Theminestone/AutoTuner/project management/fotos/AutoTune.jpg

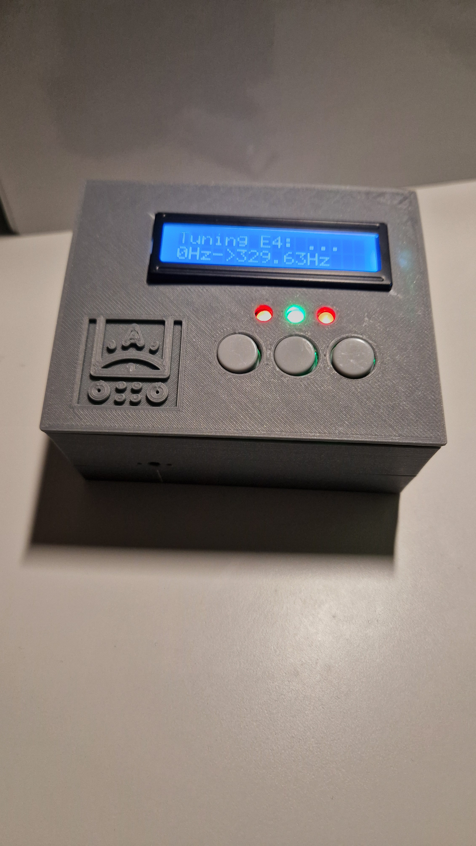
project management/fotos/AutoTune.jpg
