Theminestone/AutoTuner/project management/fotos/autotunerwide.jpg

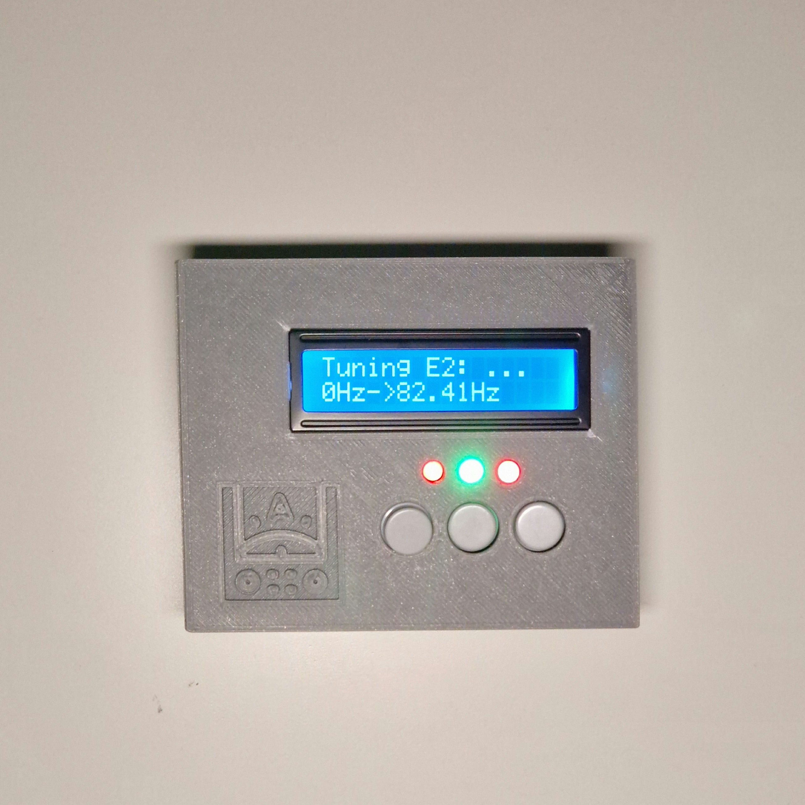
project management/fotos/autotunerwide.jpg
