Theminestone/AutoTuner/README.md

# AutoTuner
TFO Meran 2023 / 2024 - Maturaprojekt
