Theminestone/AutoTuner/pcb/v3/jlcpcb_part_placement.png

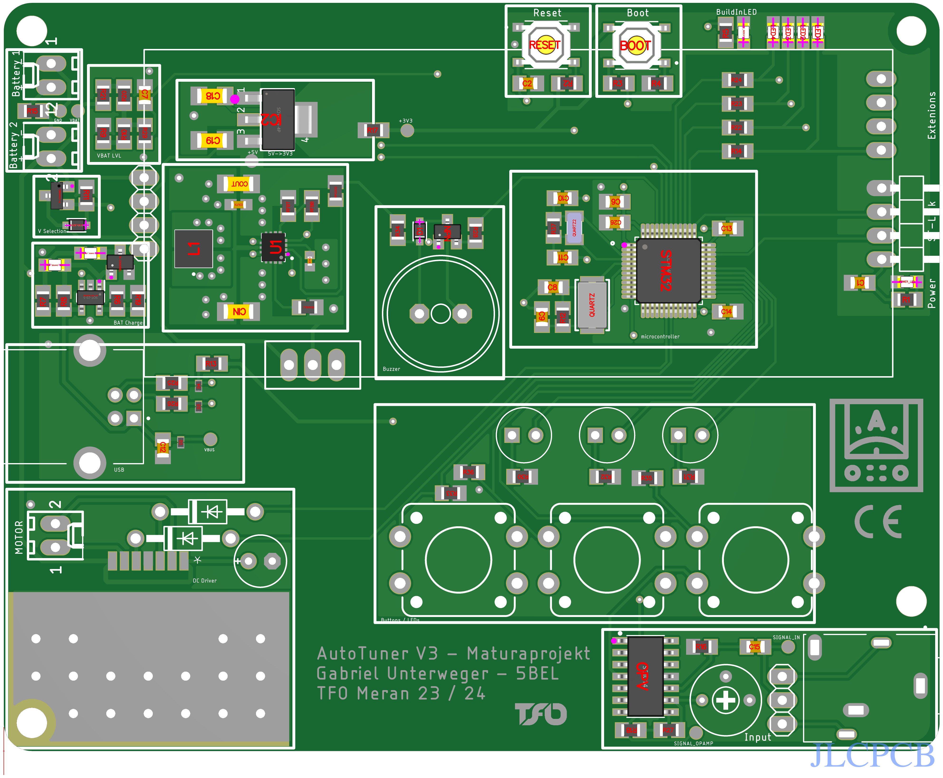
pcb/v3/jlcpcb_part_placement.png
