Theminestone/AutoTuner/pcb/v3/schematic1.png

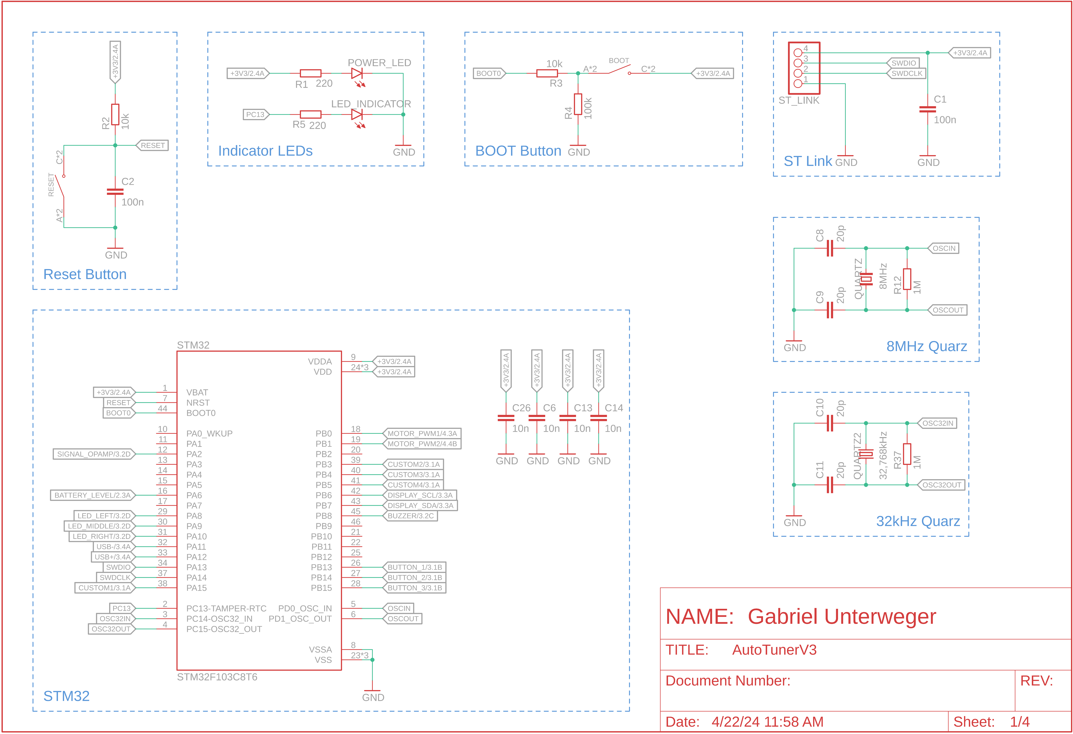
pcb/v3/schematic1.png
