Theminestone/AutoTuner/pcb/v3/schematic2.png

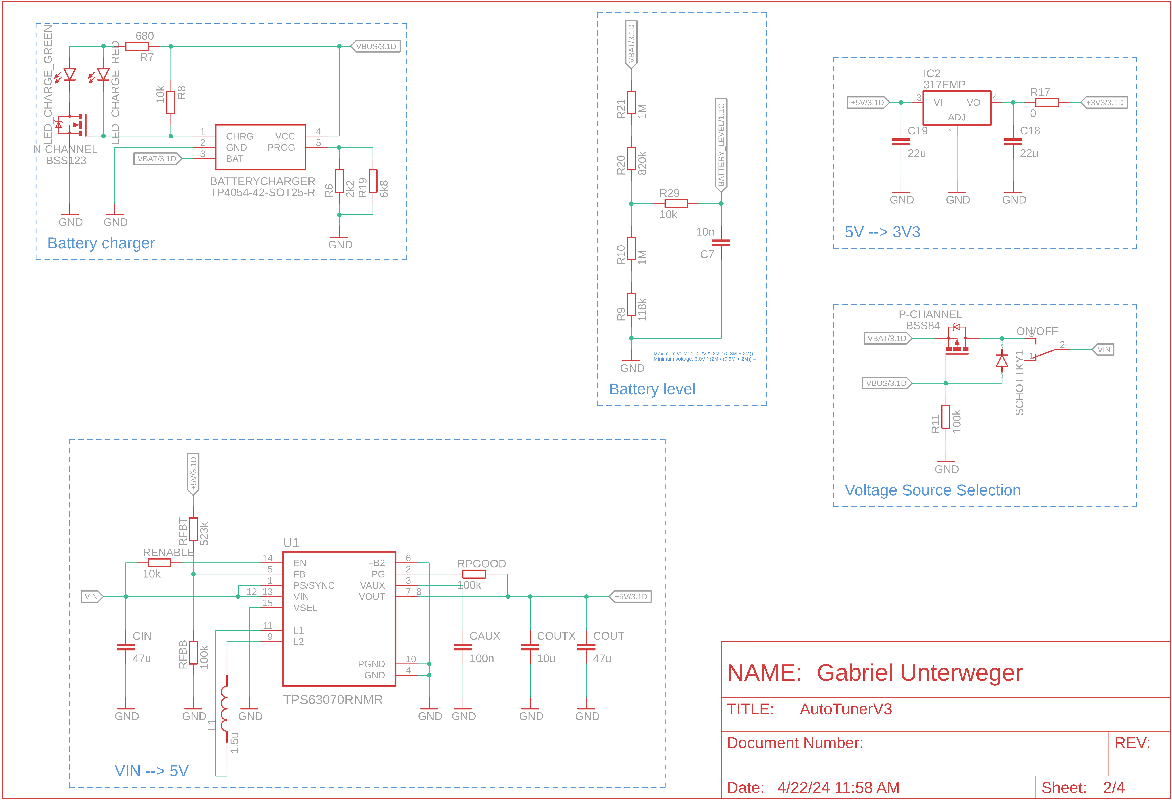
pcb/v3/schematic2.png
