Theminestone/AutoTuner/pcb/v3/schematic3.png

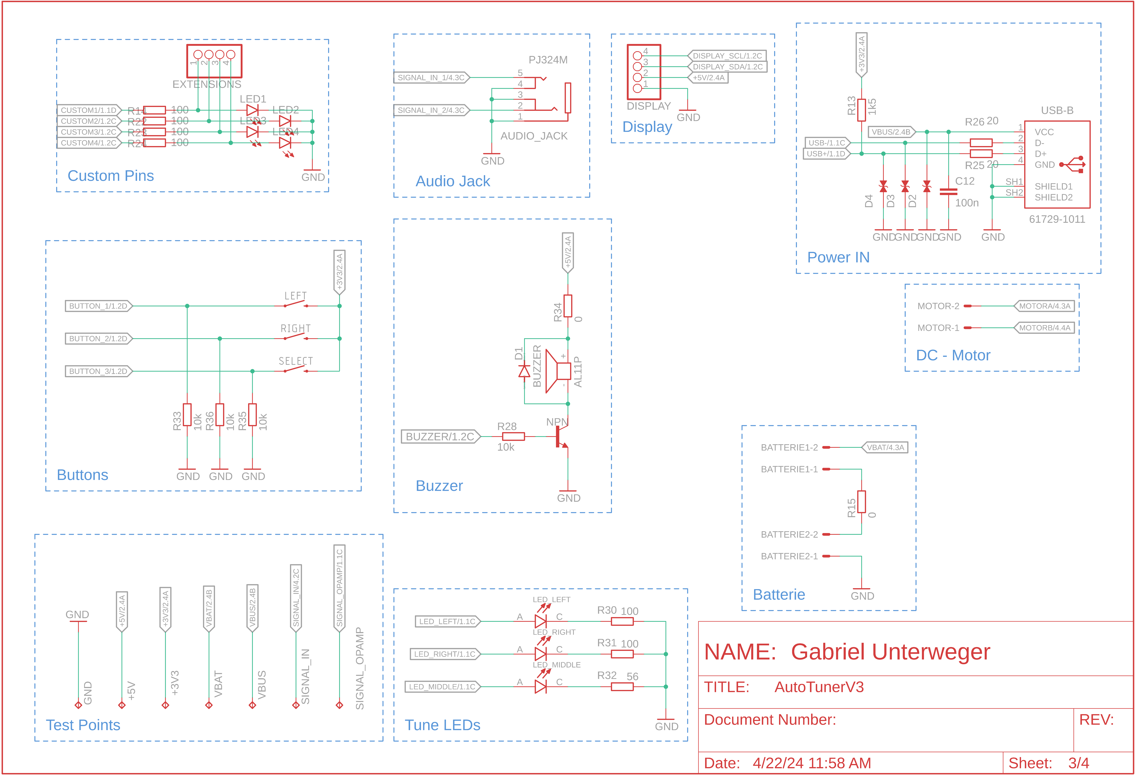
pcb/v3/schematic3.png
