Theminestone/AutoTuner/pcb/v3/schematic4.png

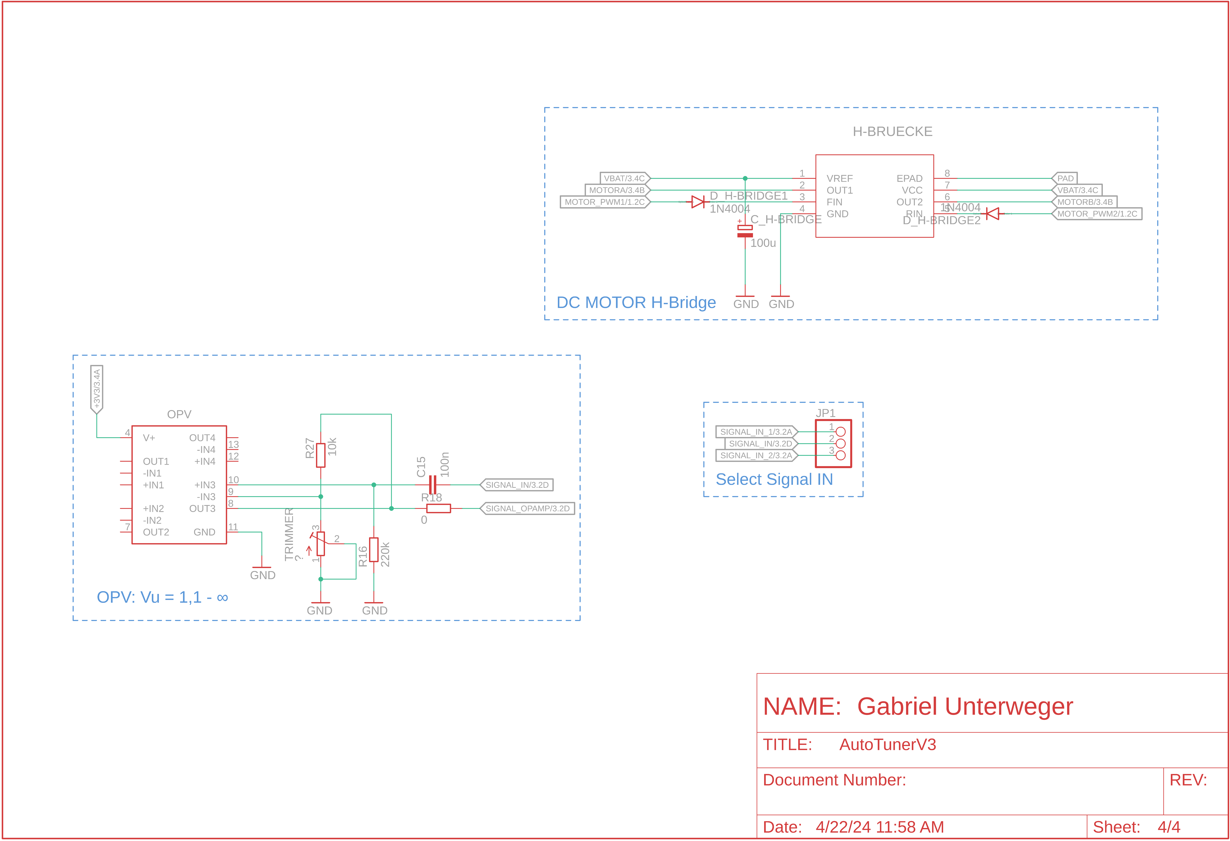
pcb/v3/schematic4.png
