Theminestone/AutoTuner/project management/fotos/20240527_224813.jpg

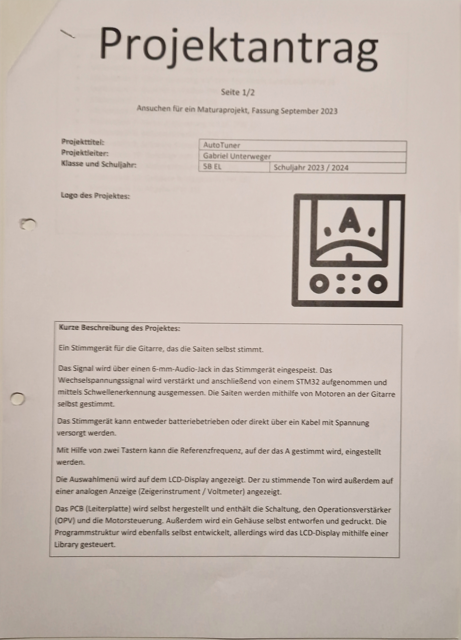
project management/fotos/20240527_224813.jpg
