Theminestone/AutoTuner/project management/fotos/20240527_224911.jpg

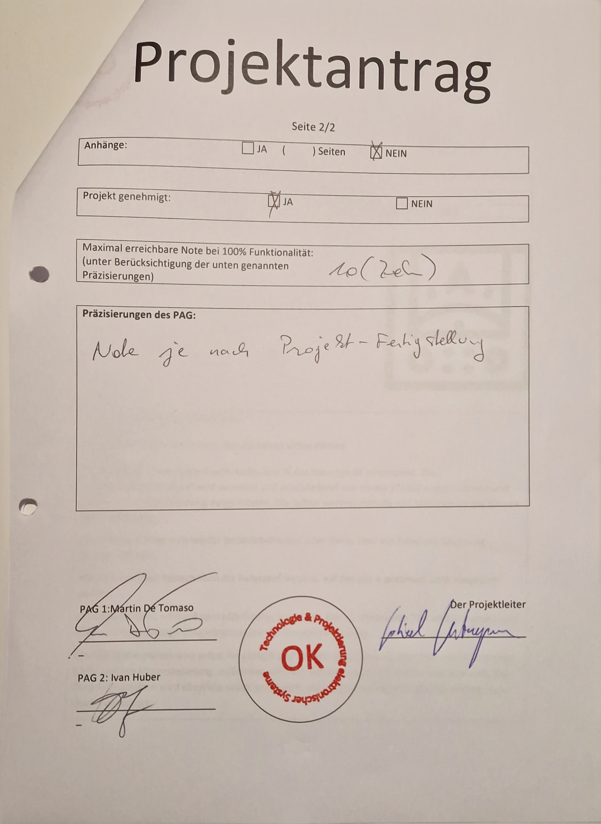
project management/fotos/20240527_224911.jpg
