Theminestone/AutoTuner/project management/fotos/20240527_225200.jpg

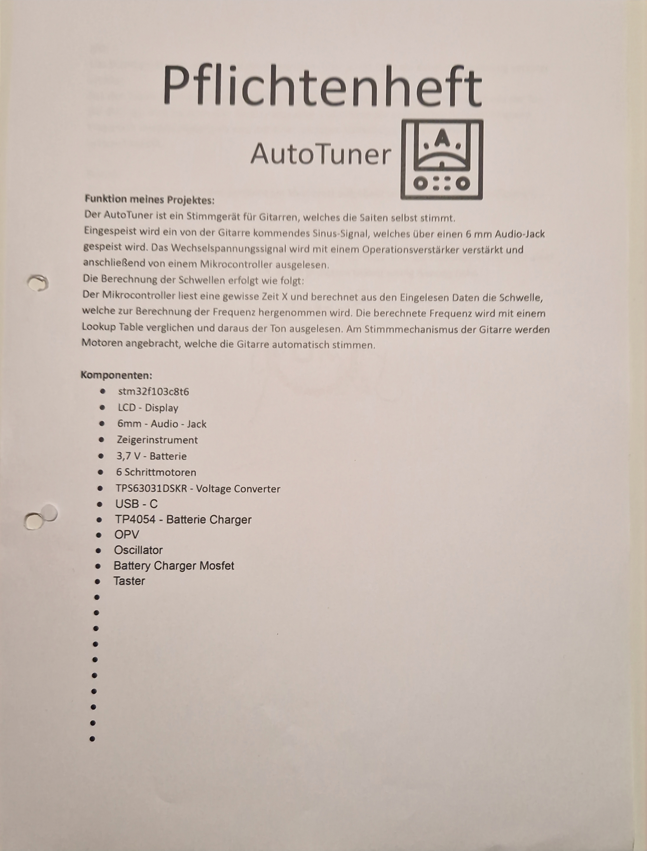
project management/fotos/20240527_225200.jpg
