Theminestone/AutoTuner/project management/fotos/20240527_225217.jpg

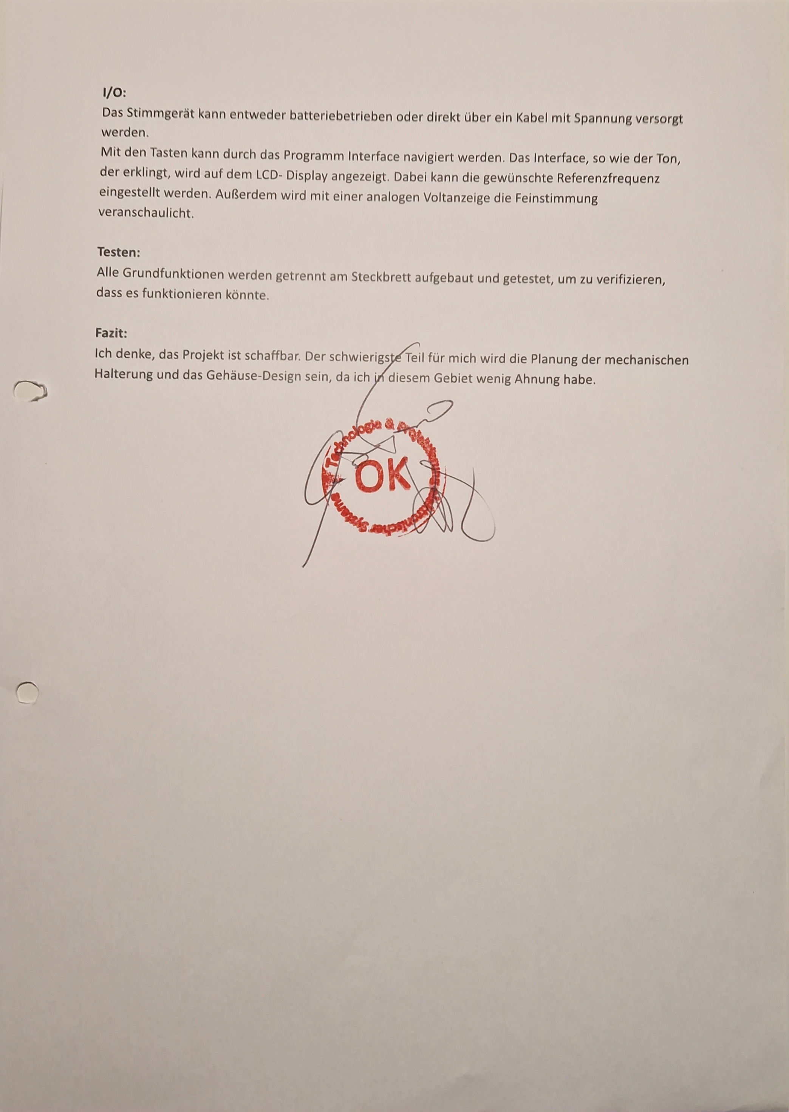
project management/fotos/20240527_225217.jpg
