Theminestone/AutoTuner/project management/fotos/autotuner.jpg

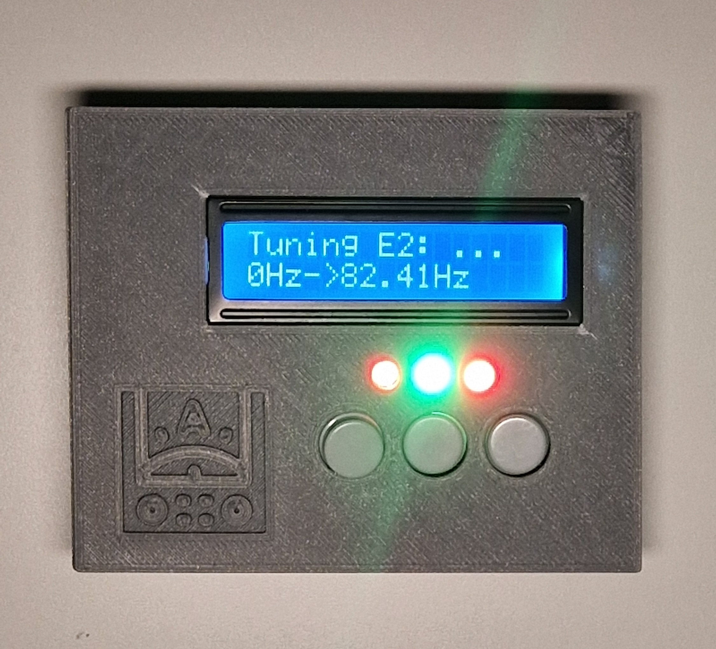
project management/fotos/autotuner.jpg
