Theminestone/AutoTuner/project management/fotos/erstes signal2.png

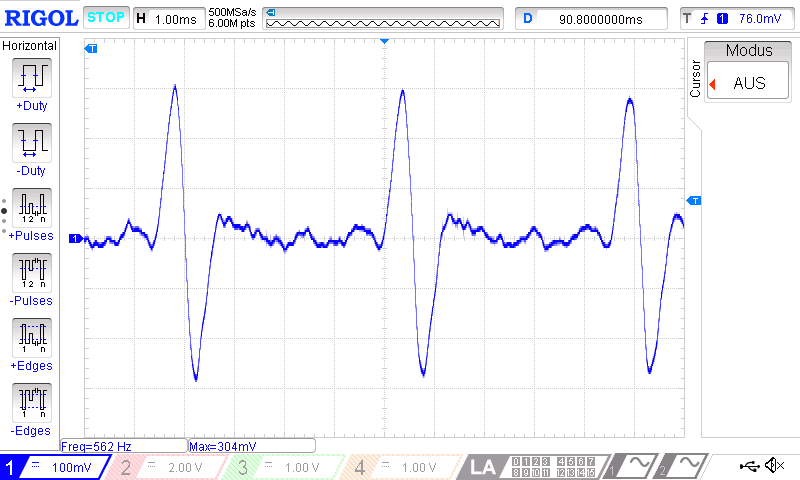
project management/fotos/erstes signal2.png
