Theminestone/AutoTuner/project management/doku/Arbeitsstunden.ods

Sheet: stunden
 | Stunden
Projektwoche | In der Schule | Offenes Labor | Zuhause | Gesammt | Kosten | 40 | €/h
1 | 5 | 0 | 2 | 7 | € 280.00
2 | 5 | 0 | 0 | 5 | € 200.00
3 | 5 | 0 | 0 | 5 | € 200.00
4 | 5 | 0 | 2 | 7 | € 280.00
5 | 5 | 0 | 0 | 5 | € 200.00
6 | 5 | 0 | 0 | 5 | € 200.00
7 | 5 | 0 | 5 | 10 | € 400.00
8 | 5 | 0 | 6 | 11 | € 440.00
9 | 5 | 0 | 12 | 17 | € 680.00
10 | 5 | 0 | 15 | 20 | € 800.00
11 | 5 | 0 | 25 | 30 | € 1,200.00
12 | 3 | 0 | 12 | 15 | € 600.00
13 | 5 | 0 | 8 | 13 | € 520.00
14 | 5 | 0 | 3 | 8 | € 320.00
15 | 0 | 0 | 2 | 2 | € 80.00
16 | 0 | 0 | 4 | 4 | € 160.00
17 | 2 | 0 | 0 | 2 | € 80.00
18 | 5 | 0 | 2 | 7 | € 280.00
19 | 5 | 0 | 0 | 5 | € 200.00
20 | 5 | 0 | 0 | 5 | € 200.00
21 | 5 | 0 | 0 | 5 | € 200.00
22 | 0 | 0 | 3 | 3 | € 120.00
23 | 2 | 0 | 2 | 4 | € 160.00
24 | 5 | 0 | 0 | 5 | € 200.00
25 | 1 | 0 | 0 | 1 | € 40.00
26 | 5 | 0 | 10 | 15 | € 600.00
27 | 5 | 0 | 12 | 17 | € 680.00
28 | 3 | 0 | 7 | 10 | € 400.00
29 | 2 | 0 | 8 | 10 | € 400.00
30 | 2 | 0 | 6 | 8 | € 320.00
31 | 5 | 0 | 5 | 10 | € 400.00
32 | 3 | 2.5 | 4 | 9.5 | € 380.00
33 | 2 | 0 | 3 | 5 | € 200.00
34 | 0 | 0 | 0 | 0 | € 0.00
35 | 0 | 0 | 2 | 2 | € 80.00
36 | 1 | 0 | 12 | 13 | € 520.00
Gesammt | 126 | 2.5 | 172 | 300.5 | € 12,020.00
IVA |  |  |  | 23.00% | € 2,764.60
Gesammt mit IVA |  |  |  |  | € 9,255.40

Sheet: berater
Datum | Stunden | Berater | Kosten
26.09.2023 | 0.25 | Huber Ivan | € 20.00 | 80 | €/h
28.09.2023 | 0.25 | Detomaso Martin | € 20.00
24.10.2023 | 0.25 | Yegorov Vladislav | € 20.00
21.11.2023 | 0.5 | Yegorov Vladislav | € 40.00
23.11.2023 | 0.5 | Yegorov Vladislav | € 40.00
23.11.2023 | 0.25 | Detomaso Martin | € 20.00
14.03.2024 | 0.25 | Tibolla Fabian | € 20.00
19.03.2024 | 3 | Tibolla Fabian | € 240.00
Gesamt | 5.25 |  | € 420.00

Sheet: materia
Art | Name | Anzahl | Einzelpreis | Gesamtpreis
Widerstände | R0805 | 152 | € 0.00 | € 0.24
Kondensatoren | C0805 | 38 | € 0.01 | € 0.23 | jlcpcb
Dioden | H5VL10B, 1N4148WS und 1N5819WS | 24 | € 0.01 | € 0.24
MOSFET P-Channel | BSS84 | 10 | € 0.02 | € 0.20
Quarz | Q13FC13500004 und X50328MSB2GI | 4 | € 0.16 | € 0.64
Spannungswandler | TPS63070RNMR | 2 | € 0.60 | € 1.20
Leds | KT-0805 | 16 | € 0.01 | € 0.21
STM32 | STM32F103C8T6 | 2 | € 1.25 | € 2.49
MOSFET N-Channel | AO3400A | 2 | € 0.07 | € 0.14
Battery Charger | TP4054-42-SOT25R | 5 | € 0.13 | € 0.64
OPAMP | LM324DT | 2 | € 0.12 | € 0.24
Spule | XFL4020-152MEC | 2 | € 1.09 | € 2.18
Taster | TS-1187A-B-A-B | 4 | € 0.02 | € 0.06
Transistor NPN | S8050-J3Y | 10 | € 0.01 | € 0.08
Spannungswandler | AMS1117-3.3 | 2 | € 0.13 | € 0.27
Extended Parts |  |  |  | € 26.00
pcb |  |  |  | -4
shipping |  |  |  | € 20.00
Steuer (22^) |  |  |  | 10.69
Gesamt |  |  |  | € 61.76
Art | Name | Anzahl | Einzelpreis | Gesamtpreis
Batterie | 6060100 3.7V 5000mAh Rechargeable LiIon Battery | 2 | € 4.86 | € 9.72
THT Leds | 5mm THT LEDs | 3 | € 0.00 | € 0.00
Pin Heads | 2,4mm Pinheads | 2 | € 0.00 | € 0.00 | extra
Schalter | 3 Pin Schalter | 1 | € 0.00 | € 0.00
Trimmer | THT Trimmer | 2 | € 0.00 | € 0.00
Display | 4 PIN LCD Display | 1 | € 0.00 | € 0.00
H-Brücke | ROHM H-BRIDGE 18V (BD6222HFP-TR) | 2 | € 4.09 | € 8.18
Motor | 6V DC Motor mit Getriebe | 2 | € 2.35 | € 4.70
Buzzer | Passiver Buzzer | 1 | € 0.00 | € 0.00
Taster | Taster mit Rundem Aufsatz | 3 | € 0.00 | € 0.00
Audio Jack | 3.5mm Audio Jack Female | 2 | € 1.00 | € 2.00
USB-B | USB-B Female | 2 | € 1.00 | € 2.00
Gesamt |  |  | € 4.86 | € 26.60

Sheet: gesamt
Gesamtkosten
 | Arbeitsstunden | € 12,020.00
 | Beraterstunden | € 420.00
 | Bestückt | € 61.76
 | Nicht Bestückt | € 26.60
 | Gesamt | € 12,528.36
