Theminestone/AutoTuner/case/Deckel.stl

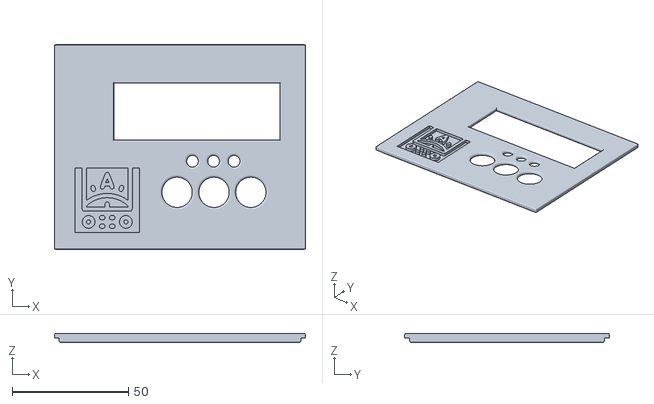
[picture p15: CAD file, 2024-05-06]
case/Deckel.stl
108.0 x 88.0 x 4.00
