Theminestone/AutoTuner/case/Motor_Aufsatz.stl

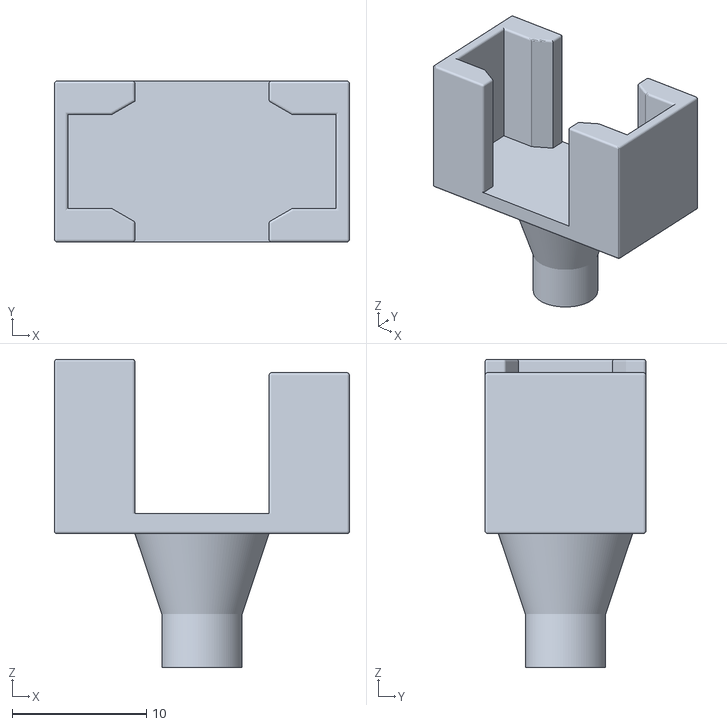
[picture p16: CAD file, 2024-04-04]
case/Motor_Aufsatz.stl
22.0 x 12.0 x 23.0
