Theminestone/AutoTuner/case/Gehaeuse.stl

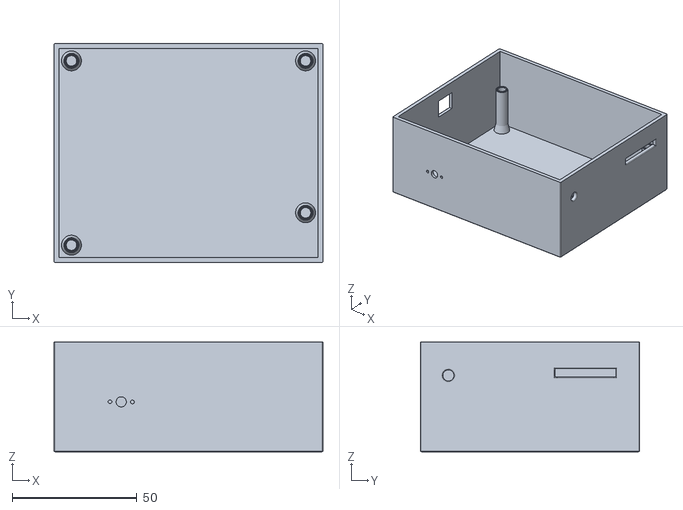
[picture p17: CAD file, 2024-04-04]
case/Gehaeuse.stl
108.0 x 88.0 x 44.0
