Theminestone/AutoTuner/pcb/v2/AutoTunerV2.brd

## EAGLE design pcb/v2/AutoTunerV2.brd (2024-06-03, an earlier design)

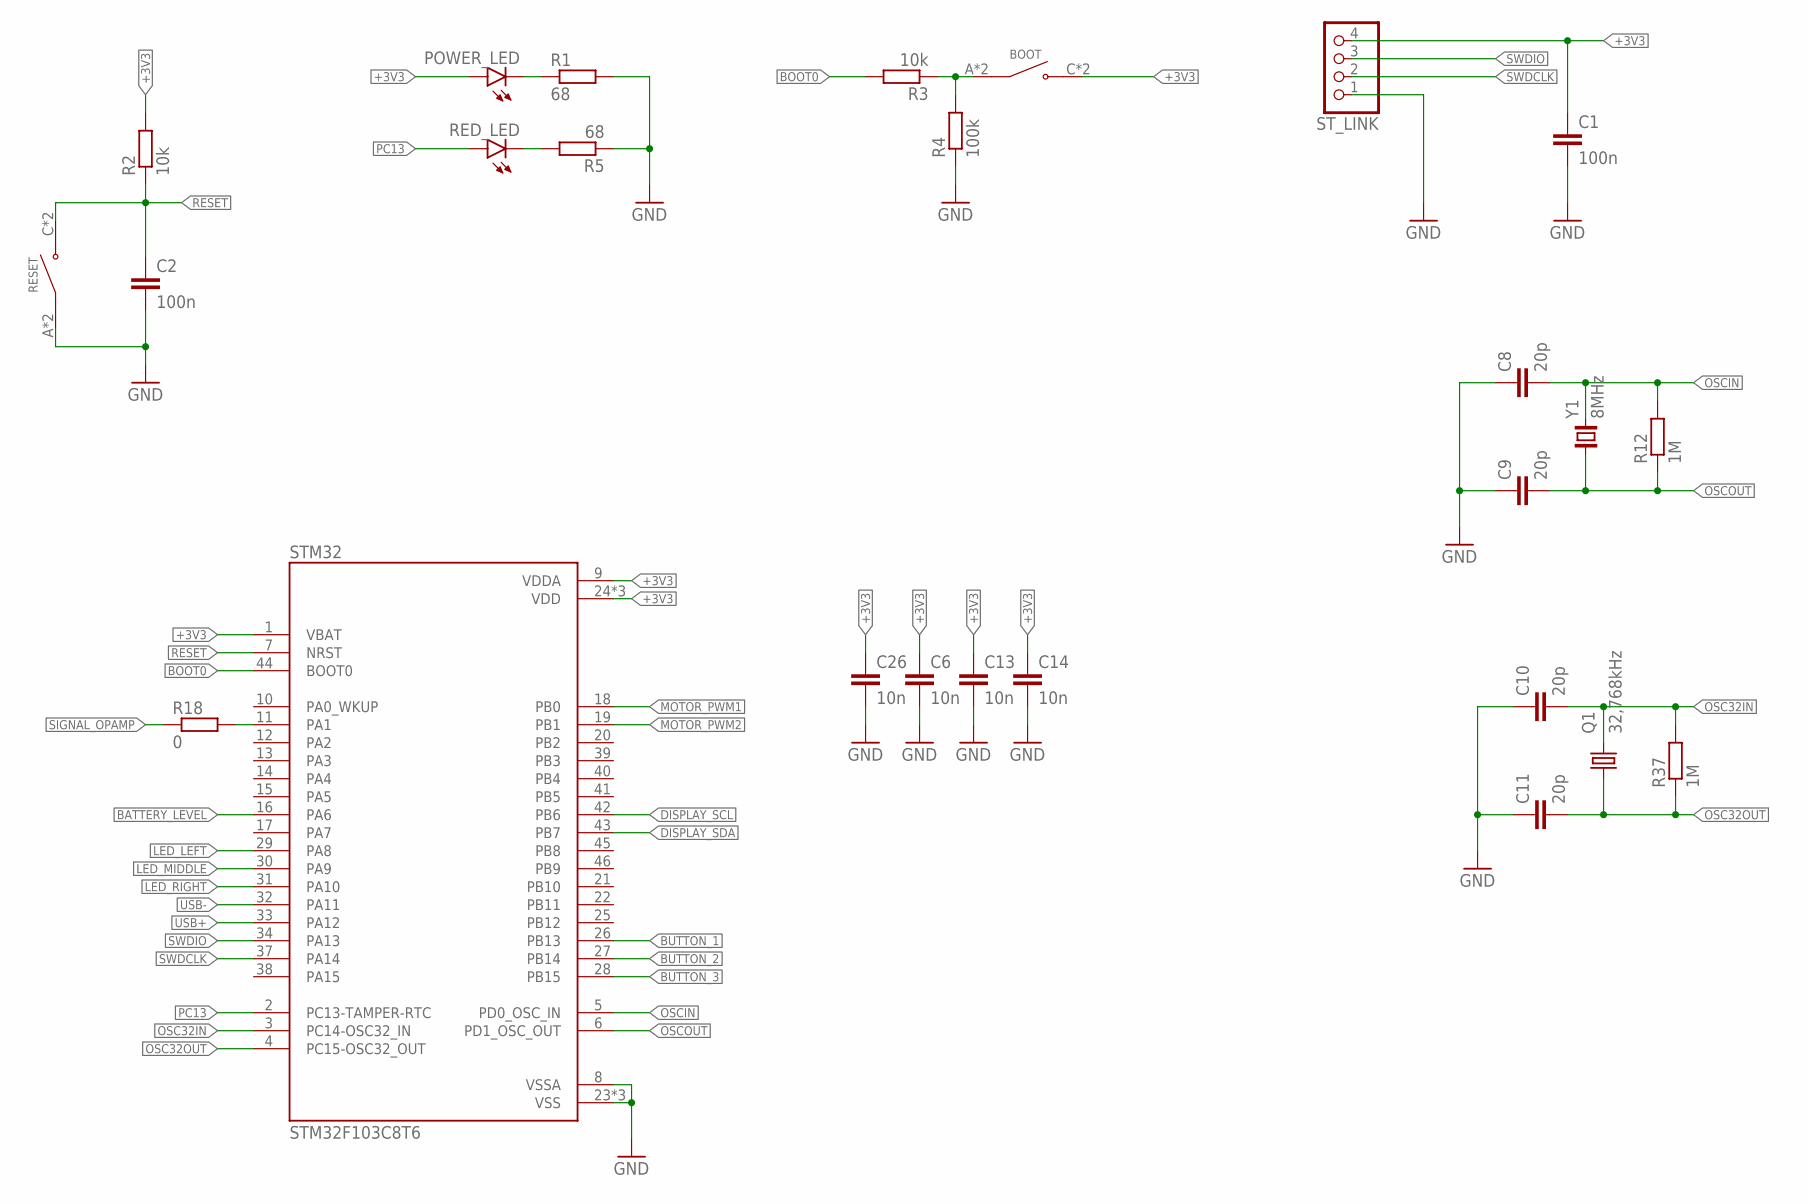
[picture p18: schematic AutoTunerV2.sch, sheet 1, mcu]

Parts:
BOOT: TS-1187A-B-A-B; SW_TS-1187A-B-A-B; LCSC_PART C318884
C1, C2: 100n; C0805
C6, C13, C14, C26: 10n; C0805
C8, C9, C10, C11: 20p; C0805
POWER_LED: LEDCHIPLED_0805; CHIPLED_0805; LCSC_PART C2297
Q1: 32,768kHz; 3.2X1.5; LCSC_PART C32346
R1, R5: 68; R0805; LCSC_PART C17802
R2, R3: 10k; R0805
R4: 100k; R0805
R12, R37: 1M; R0805
R18: 0; R0805
RED_LED: LEDCHIPLED_0805; CHIPLED_0805; LCSC_PART C84256
RESET: TS-1187A-B-A-B; SW_TS-1187A-B-A-B; LCSC_PART C318884
STM32: STM32F103C8T6; QFP50P900X900X160-48N; LCSC_PART C8734
ST_LINK: PINHD-1X4; 1X04
Y1: 8MHz; CRYSTAL_2-SMD-5X3; LCSC_PART C115962

Connections:
+3V3: BOOT.C (NO), BOOT.D (NO), C1.1, C6.1, C13.1, C14.1, C26.1, POWER_LED.A, R2.2, STM32.1 (VBAT), STM32.9 (VDDA), STM32.24 (VDD), STM32.36 (VDD), STM32.48 (VDD), ST_LINK.4; also elsewhere on the board
BATTERY_LEVEL: STM32.16 (PA6); also elsewhere on the board
BOOT0: R3.2, STM32.44 (BOOT0)
BUTTON_1: STM32.26 (PB13); also elsewhere on the board
BUTTON_2: STM32.27 (PB14); also elsewhere on the board
BUTTON_3: STM32.28 (PB15); also elsewhere on the board
DISPLAY_SCL: STM32.42 (PB6); also elsewhere on the board
DISPLAY_SDA: STM32.43 (PB7); also elsewhere on the board
GND: C1.2, C2.2, C6.2, C8.1, C9.1, C10.1, C11.1, C13.2, C14.2, C26.2, R1.2, R4.1, R5.1, RESET.A (COM), RESET.B (COM), STM32.8 (VSSA), STM32.23 (VSS), STM32.35 (VSS), STM32.47 (VSS), ST_LINK.1; also elsewhere on the board
LED_LEFT: STM32.29 (PA8); also elsewhere on the board
LED_MIDDLE: STM32.30 (PA9); also elsewhere on the board
LED_RIGHT: STM32.31 (PA10); also elsewhere on the board
MOTOR_PWM1: STM32.18 (PB0); also elsewhere on the board
MOTOR_PWM2: STM32.19 (PB1); also elsewhere on the board
unnamed: R5.2, RED_LED.C
unnamed: POWER_LED.C, R1.1
unnamed: BOOT.A (COM), BOOT.B (COM), R3.1, R4.2
unnamed: R18.2, STM32.11 (PA1)
OSC32IN: C10.2, Q1.2, R37.2, STM32.3 (PC14-OSC32_IN)
OSC32OUT: C11.2, Q1.1, R37.1, STM32.4 (PC15-OSC32_OUT)
OSCIN: C8.2, R12.2, STM32.5 (PD0_OSC_IN), Y1.2
OSCOUT: C9.2, R12.1, STM32.6 (PD1_OSC_OUT), Y1.1
PC13: RED_LED.A, STM32.2 (PC13-TAMPER-RTC)
RESET: C2.1, R2.1, RESET.C (NO), RESET.D (NO), STM32.7 (NRST)
SIGNAL_OPAMP: R18.1; also elsewhere on the board
SWDCLK: STM32.37 (PA14), ST_LINK.2
SWDIO: STM32.34 (PA13), ST_LINK.3
USB+: STM32.33 (PA12); also elsewhere on the board
USB-: STM32.32 (PA11); also elsewhere on the board

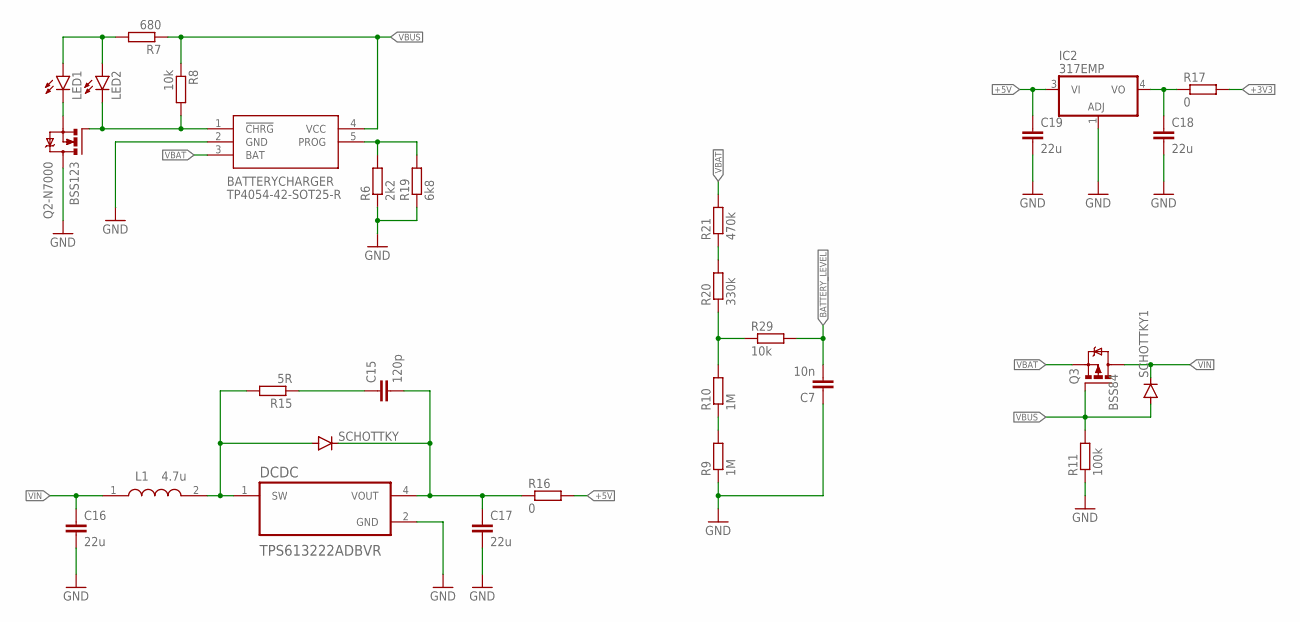
[picture p19: schematic AutoTunerV2.sch, sheet 2, battery / voltage converter]

Parts:
BATTERYCHARGER: TP4054-42-SOT25-R; SOT95P280X100-5N; LCSC_PART C32574
C7: 10n; C0805
C15: 120p; C0805
C16, C17, C18, C19: 22u; C1206; LCSC_PART C5672
DCDC: TPS613222ADBVR; SOT95P280X145-5N; LCSC_PART C2071163
IC2: 317EMP; SOT223; LCSC_PART C6186
L1: 4.7u; DFE2HCAH1R0MJ0L; LCSC_PART C3093670
LED1: LEDCHIPLED_0805; CHIPLED_0805; LCSC_PART C2297
LED2: LEDCHIPLED_0805; CHIPLED_0805; LCSC_PART C84256
Q2-N7000: BSS123; SOT23; LCSC_PART C20917
Q3: BSS84; SOT23; LCSC_PARTS C10487
R6: 2k2; R0805
R7: 680; R0805
R8, R29: 10k; R0805
R9, R10: 1M; R0805
R11: 100k; R0805
R15: 5R; R0805
R16, R17: 0; R0805
R19: 6k8; R0805
R20: 330k; R0805
R21: 470k; R0805
SCHOTTKY, SCHOTTKY1: DIODE-SOD323-R; SOD323-R; LCSC_PART C191023

Connections:
+3V3: R17.2; also elsewhere on the board
+5V: C19.1, IC2.3 (VI), R16.2; also elsewhere on the board
BATTERY_LEVEL: C7.2, R29.2; also elsewhere on the board
GND: BATTERYCHARGER.2 (GND), C7.1, C16.2, C17.2, C18.2, C19.2, DCDC.2 (GND), IC2.1 (ADJ), Q2-N7000.3 (D), R6.1, R9.1, R11.1, R19.1; also elsewhere on the board
unnamed: DCDC.1 (SW), L1.2, R15.2, SCHOTTKY.A
unnamed: R9.2, R10.1
unnamed: C15.2, C17.1, DCDC.4 (VOUT), R16.1, SCHOTTKY.C
unnamed: BATTERYCHARGER.5 (PROG), R6.2, R19.2
unnamed: BATTERYCHARGER.1 (!CHRG), LED2.C, Q2-N7000.1 (G), R8.2
unnamed: C15.1, R15.1
unnamed: LED1.A, LED2.A, R7.2
unnamed: LED1.C, Q2-N7000.2 (S)
unnamed: C18.1, IC2.4 (VO), R17.1
unnamed: R20.2, R21.1
unnamed: R10.2, R20.1, R29.1
VBAT: BATTERYCHARGER.3 (BAT), Q3.2 (S), R21.2; also elsewhere on the board
VBUS: BATTERYCHARGER.4 (VCC), Q3.1 (G), R7.1, R8.1, R11.2, SCHOTTKY1.A; also elsewhere on the board
VIN: C16.1, L1.1, Q3.3 (D), SCHOTTKY1.C

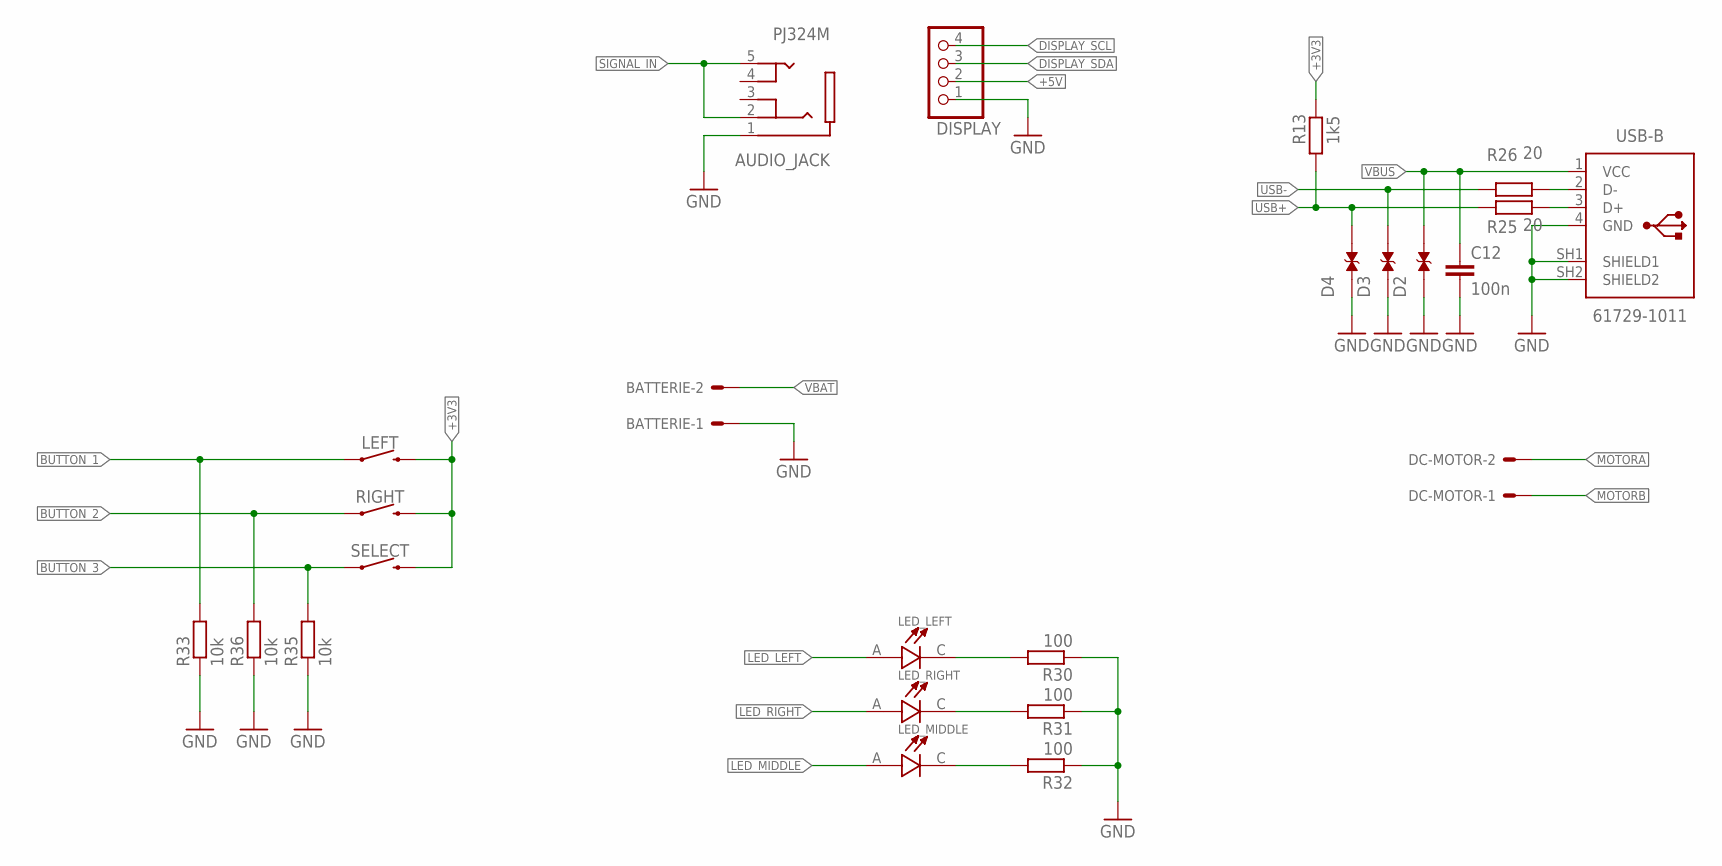
[picture p20: schematic AutoTunerV2.sch, sheet 3, I/O]

Parts:
AUDIO_JACK: PJ324M; WENZHOU_PJ324M
BATTERIE: 22-27-2021-02; 6410-02
C12: 100n; C0805
D2, D3, D4: TESD5V0L1UC_RJG; DIO_TESD5V0L1UC_RJG; LCSC_PART C7420372
DC-MOTOR: 22-27-2021-02; 6410-02
DISPLAY: PINHD-1X4; 1X04
LED_LEFT: L-53GD; LEDRD254W50D500H1060
LED_MIDDLE: L-53GD; LEDRD254W50D500H1060
LED_RIGHT: L-53GD; LEDRD254W50D500H1060
LEFT: MOMENTARY-SWITCH-SPST-PTH-12MM; TACTILE_SWITCH_PTH_12MM
R13: 1k5; R0805
R25, R26: 20; R0805
R30, R31, R32: 100; R0805
R33, R35, R36: 10k; R0805
RIGHT: MOMENTARY-SWITCH-SPST-PTH-12MM; TACTILE_SWITCH_PTH_12MM
SELECT: MOMENTARY-SWITCH-SPST-PTH-12MM; TACTILE_SWITCH_PTH_12MM
USB-B: 61729-1011; 61729-1011BLF

Connections:
+3V3: LEFT.3 (2), R13.2, RIGHT.3 (2), SELECT.3 (2); also elsewhere on the board
+5V: DISPLAY.2; also elsewhere on the board
BUTTON_1: LEFT.1, R33.2; also elsewhere on the board
BUTTON_2: R36.2, RIGHT.1; also elsewhere on the board
BUTTON_3: R35.2, SELECT.1; also elsewhere on the board
DISPLAY_SCL: DISPLAY.4; also elsewhere on the board
DISPLAY_SDA: DISPLAY.3; also elsewhere on the board
GND: AUDIO_JACK.1 (SLEEVE), BATTERIE.1, C12.2, D2.1, D3.1, D4.1, DISPLAY.1, R30.1, R31.1, R32.1, R33.1, R35.1, R36.1, USB-B.4 (GND), USB-B.SH1 (SHIELD1), USB-B.SH2 (SHIELD2); also elsewhere on the board
LED_LEFT: LED_LEFT.A; also elsewhere on the board
LED_MIDDLE: LED_MIDDLE.A; also elsewhere on the board
LED_RIGHT: LED_RIGHT.A; also elsewhere on the board
MOTORA: DC-MOTOR.2; also elsewhere on the board
MOTORB: DC-MOTOR.1; also elsewhere on the board
unnamed: LED_LEFT.C, R30.2
unnamed: LED_RIGHT.C, R31.2
unnamed: LED_MIDDLE.C, R32.2
unnamed: R25.2, USB-B.3 (D+)
unnamed: R26.2, USB-B.2 (D-)
SIGNAL_IN: AUDIO_JACK.2 (RING_1), AUDIO_JACK.5 (TIP_2); also elsewhere on the board
USB+: D4.2, R13.1, R25.1; also elsewhere on the board
USB-: D3.2, R26.1; also elsewhere on the board
VBAT: BATTERIE.2; also elsewhere on the board
VBUS: C12.1, D2.2, USB-B.1 (VCC); also elsewhere on the board

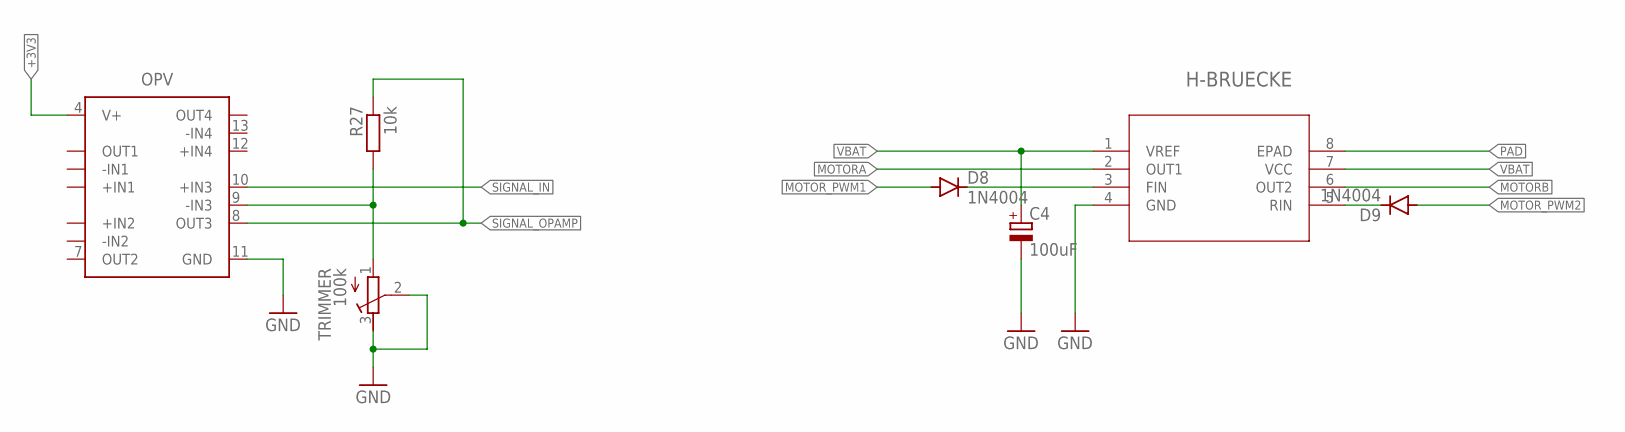
[picture p21: schematic AutoTunerV2.sch, sheet 4, Motor Steuerung / Signal Verarbeitung]

Parts:
C4: 100uF; B45181A
D8, D9: 1N4004; DO41-10
H-BRUECKE: BD6222HFP-TRHRP7_ROM-M; HRP7_ROM-M
OPV: LM324_SOIC; SOIC127P600X175-14N; LCSC_PART C71035
R27: 10k; R0805
TRIMMER: 100k; RTRIM64Y

Connections:
+3V3: OPV.4 (V+); also elsewhere on the board
GND: C4.-, H-BRUECKE.4 (GND), OPV.11 (GND), TRIMMER.2 (S), TRIMMER.3 (E); also elsewhere on the board
MOTORA: H-BRUECKE.2 (OUT1); also elsewhere on the board
MOTORB: H-BRUECKE.6 (OUT2); also elsewhere on the board
MOTOR_PWM1: D8.A; also elsewhere on the board
MOTOR_PWM2: D9.A; also elsewhere on the board
unnamed: D8.C, H-BRUECKE.3 (FIN)
unnamed: D9.C, H-BRUECKE.5 (RIN)
unnamed: OPV.9 (-IN3), R27.2, TRIMMER.1 (A)
PAD: H-BRUECKE.8 (EPAD)
SIGNAL_IN: OPV.10 (+IN3); also elsewhere on the board
SIGNAL_OPAMP: OPV.8 (OUT3), R27.1; also elsewhere on the board
VBAT: C4.+, H-BRUECKE.1 (VREF), H-BRUECKE.7 (VCC); also elsewhere on the board

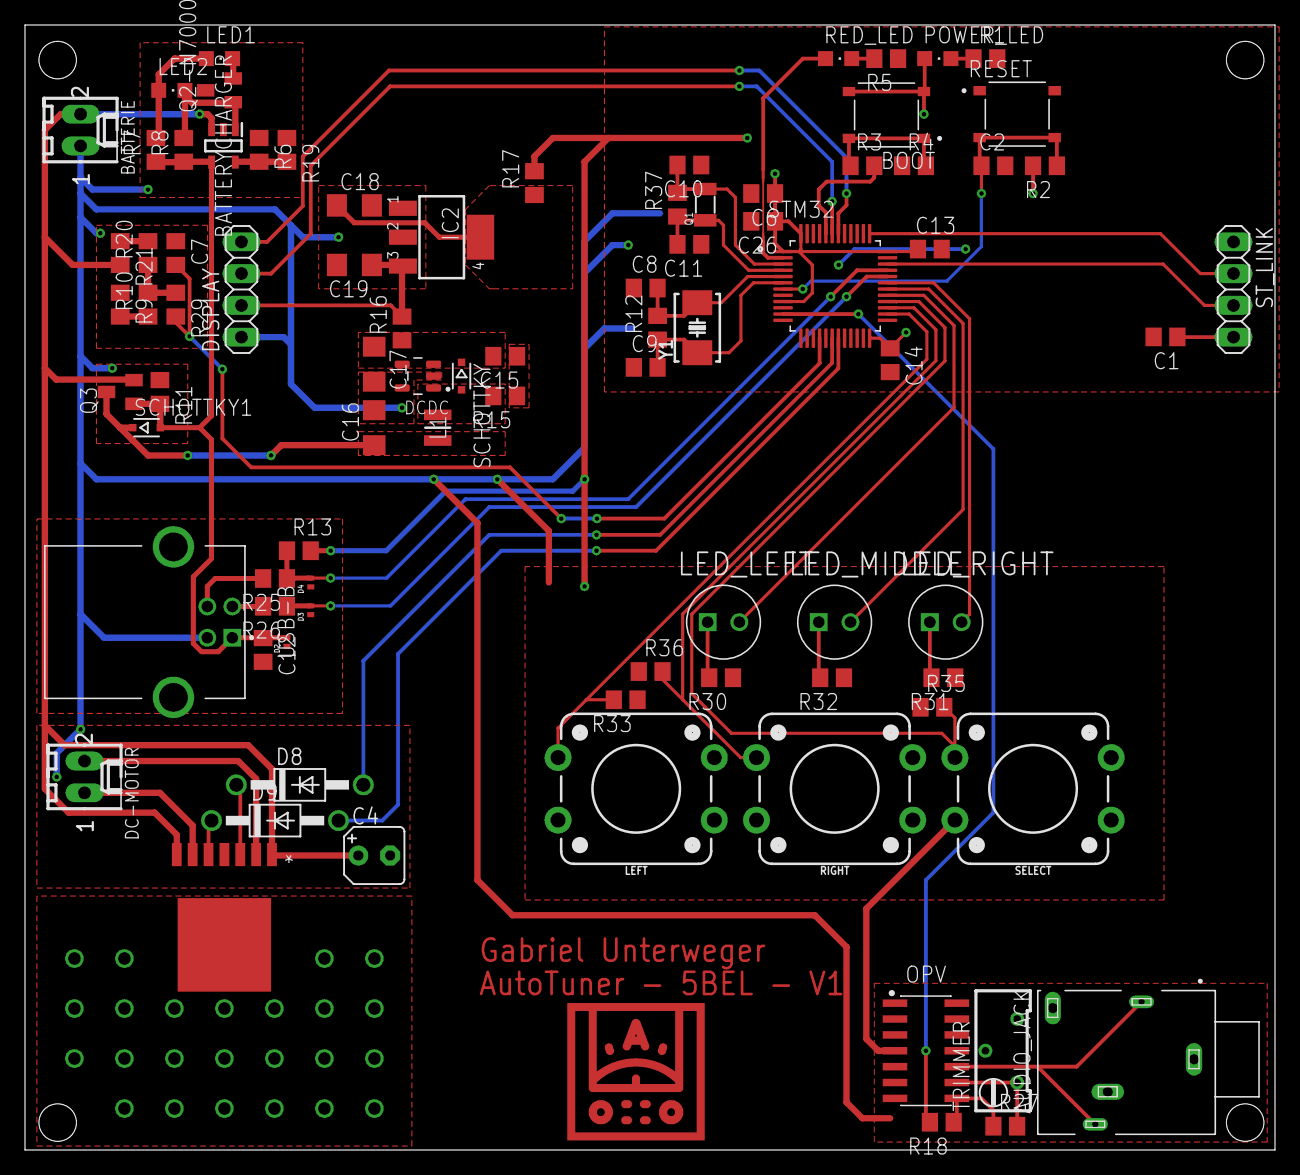
[picture p22: board AutoTunerV2.brd from above]

Board: 2 copper layers, 100.0 x 90.0 mm, 86 parts (0 on the bottom side), 55 nets.
