Theminestone/AutoTuner/pcb/v1/AutoTunerV1.brd

## EAGLE design pcb/v1/AutoTunerV1.brd (2023-12-11, an earlier design)

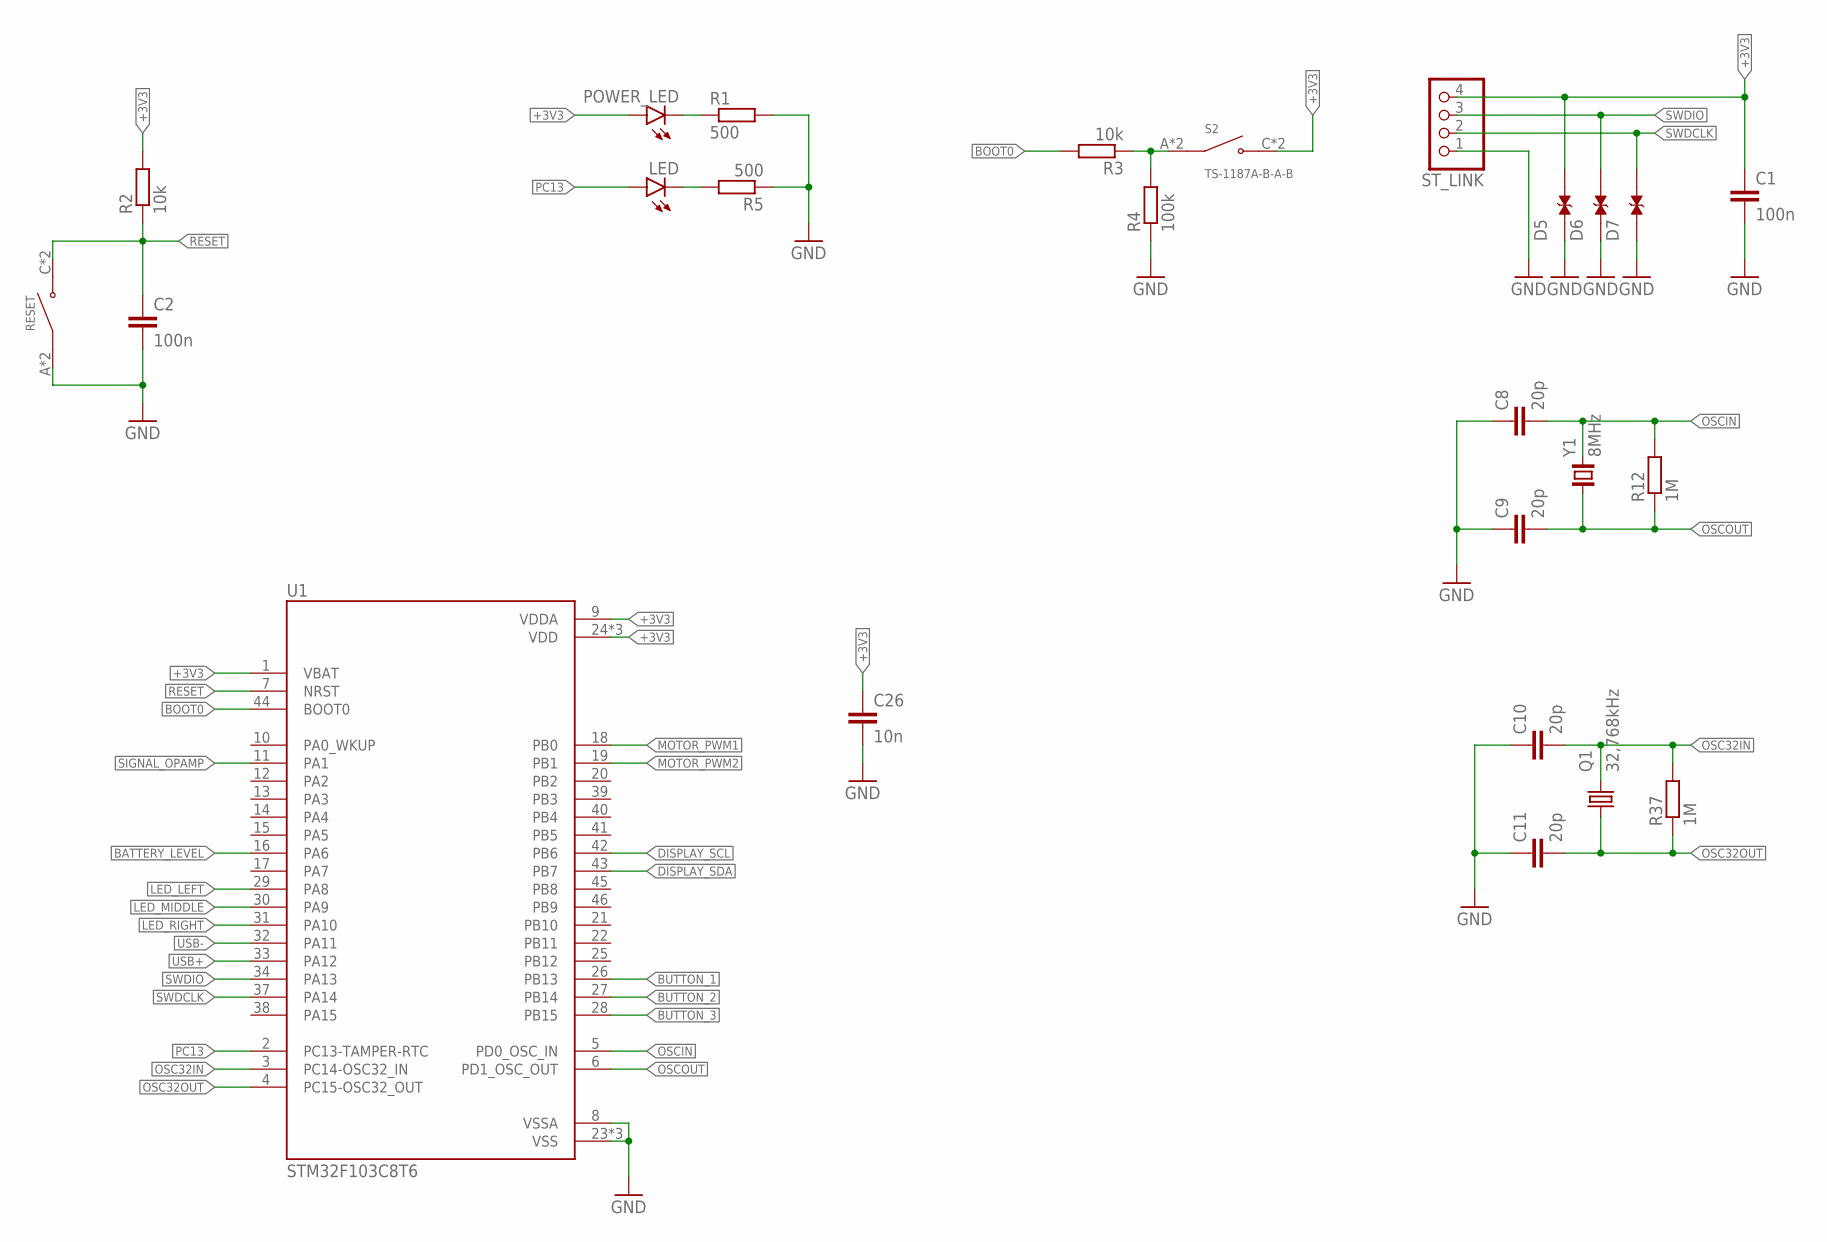
[picture p23: schematic AutoTunerV1.sch, sheet 1, mcu]

Parts:
C1, C2: 100n; C0805
C8, C9, C10, C11: 20p; C0805
C26: 10n; C0805
D5, D6, D7: TESD5V0L1UC_RJG; DIO_TESD5V0L1UC_RJG; LCSC_PART C7420372
LED: LEDCHIPLED_0805; CHIPLED_0805
POWER_LED: LEDCHIPLED_0805; CHIPLED_0805
Q1: 32,768kHz; 3.2X1.5; LCSC_PART C32346
R1, R5: 500; R0805
R2, R3: 10k; R0805
R4: 100k; R0805
R12, R37: 1M; R0805
RESET: TS-1187A-B-A-B; SW_TS-1187A-B-A-B; LCSC_PART C318884
S2: TS-1187A-B-A-B; SW_TS-1187A-B-A-B; LCSC_PART C318884
ST_LINK: PINHD-1X4; 1X04
U1: STM32F103C8T6; QFP50P900X900X160-48N; LCSC_PART C8734
Y1: 8MHz; CRYSTAL_2-SMD-5X3; LCSC_PART C115962

Connections:
+3V3: C1.1, C26.1, D5.2, POWER_LED.A, R2.2, S2.C (NO), S2.D (NO), ST_LINK.4, U1.1 (VBAT), U1.9 (VDDA), U1.24 (VDD), U1.36 (VDD), U1.48 (VDD); also elsewhere on the board
BATTERY_LEVEL: U1.16 (PA6); also elsewhere on the board
BOOT0: R3.2, U1.44 (BOOT0)
BUTTON_1: U1.26 (PB13); also elsewhere on the board
BUTTON_2: U1.27 (PB14); also elsewhere on the board
BUTTON_3: U1.28 (PB15); also elsewhere on the board
DISPLAY_SCL: U1.42 (PB6); also elsewhere on the board
DISPLAY_SDA: U1.43 (PB7); also elsewhere on the board
GND: C1.2, C2.2, C8.1, C9.1, C10.1, C11.1, C26.2, D5.1, D6.1, D7.1, R1.2, R4.1, R5.1, RESET.A (COM), RESET.B (COM), ST_LINK.1, U1.8 (VSSA), U1.23 (VSS), U1.35 (VSS), U1.47 (VSS); also elsewhere on the board
LED_LEFT: U1.29 (PA8); also elsewhere on the board
LED_MIDDLE: U1.30 (PA9); also elsewhere on the board
LED_RIGHT: U1.31 (PA10); also elsewhere on the board
MOTOR_PWM1: U1.18 (PB0); also elsewhere on the board
MOTOR_PWM2: U1.19 (PB1); also elsewhere on the board
unnamed: LED.C, R5.2
unnamed: POWER_LED.C, R1.1
unnamed: R3.1, R4.2, S2.A (COM), S2.B (COM)
OSC32IN: C10.2, Q1.2, R37.2, U1.3 (PC14-OSC32_IN)
OSC32OUT: C11.2, Q1.1, R37.1, U1.4 (PC15-OSC32_OUT)
OSCIN: C8.2, R12.2, U1.5 (PD0_OSC_IN), Y1.2
OSCOUT: C9.2, R12.1, U1.6 (PD1_OSC_OUT), Y1.1
PC13: LED.A, U1.2 (PC13-TAMPER-RTC)
RESET: C2.1, R2.1, RESET.C (NO), RESET.D (NO), U1.7 (NRST)
SIGNAL_OPAMP: U1.11 (PA1); also elsewhere on the board
SWDCLK: D7.2, ST_LINK.2, U1.37 (PA14)
SWDIO: D6.2, ST_LINK.3, U1.34 (PA13)
USB+: U1.33 (PA12); also elsewhere on the board
USB-: U1.32 (PA11); also elsewhere on the board

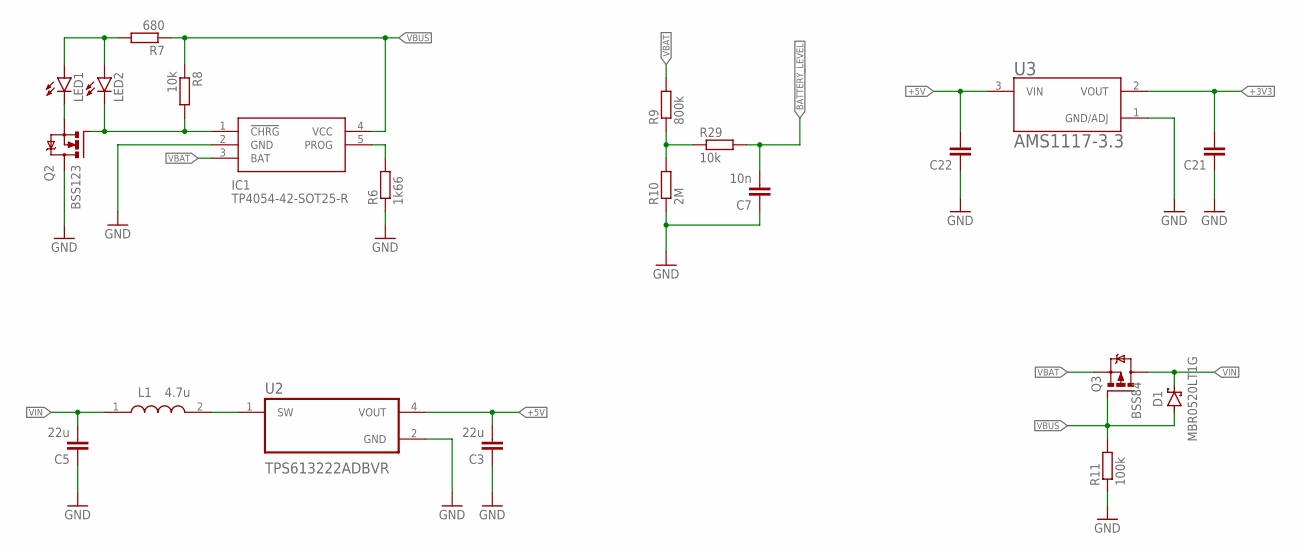
[picture p24: schematic AutoTunerV1.sch, sheet 2, battery / voltage converter]

Parts:
C3, C5: 22u; C0805
C7: 10n; C0805
C21, C22: C-EUC0805; C0805
D1: MBR0520LT1G; SODFL3718X115; LCSC_PART C191023
IC1: TP4054-42-SOT25-R; SOT95P280X100-5N; LCSC_PART C32574
L1: 4.7u; DFE2HCAH1R0MJ0L; LCSC_PART C391306
LED1, LED2: LEDCHIPLED_0805; CHIPLED_0805
Q2: BSS123; SOT23; LCSC_PART C20917
Q3: BSS84; SOT23; LCSC_PARTS C10487
R6: 1k66; R0805
R7: 680; R0805
R8, R29: 10k; R0805
R9: 800k; R0805
R10: 2M; R0805
R11: 100k; R0805
U2: TPS613222ADBVR; SOT95P280X145-5N; LCSC_PART C2071163
U3: AMS1117-3.3; SOT229P700X180-4N; LCSC_PART C6186

Connections:
+3V3: C21.2, U3.2 (VOUT); also elsewhere on the board
+5V: C3.2, C22.2, U2.4 (VOUT), U3.3 (VIN); also elsewhere on the board
BATTERY_LEVEL: C7.2, R29.2; also elsewhere on the board
GND: C3.1, C5.1, C7.1, C21.1, C22.1, IC1.2 (GND), Q2.3 (D), R6.1, R10.1, R11.1, U2.2 (GND), U3.1 (GND/ADJ); also elsewhere on the board
unnamed: L1.2, U2.1 (SW)
unnamed: R9.1, R10.2, R29.1
unnamed: IC1.5 (PROG), R6.2
unnamed: IC1.1 (!CHRG), LED2.C, Q2.1 (G), R8.2
unnamed: LED1.A, LED2.A, R7.2
unnamed: LED1.C, Q2.2 (S)
VBAT: IC1.3 (BAT), Q3.2 (S), R9.2; also elsewhere on the board
VBUS: D1.2 (A), IC1.4 (VCC), Q3.1 (G), R7.1, R8.1, R11.2; also elsewhere on the board
VIN: C5.2, D1.1 (C), L1.1, Q3.3 (D)

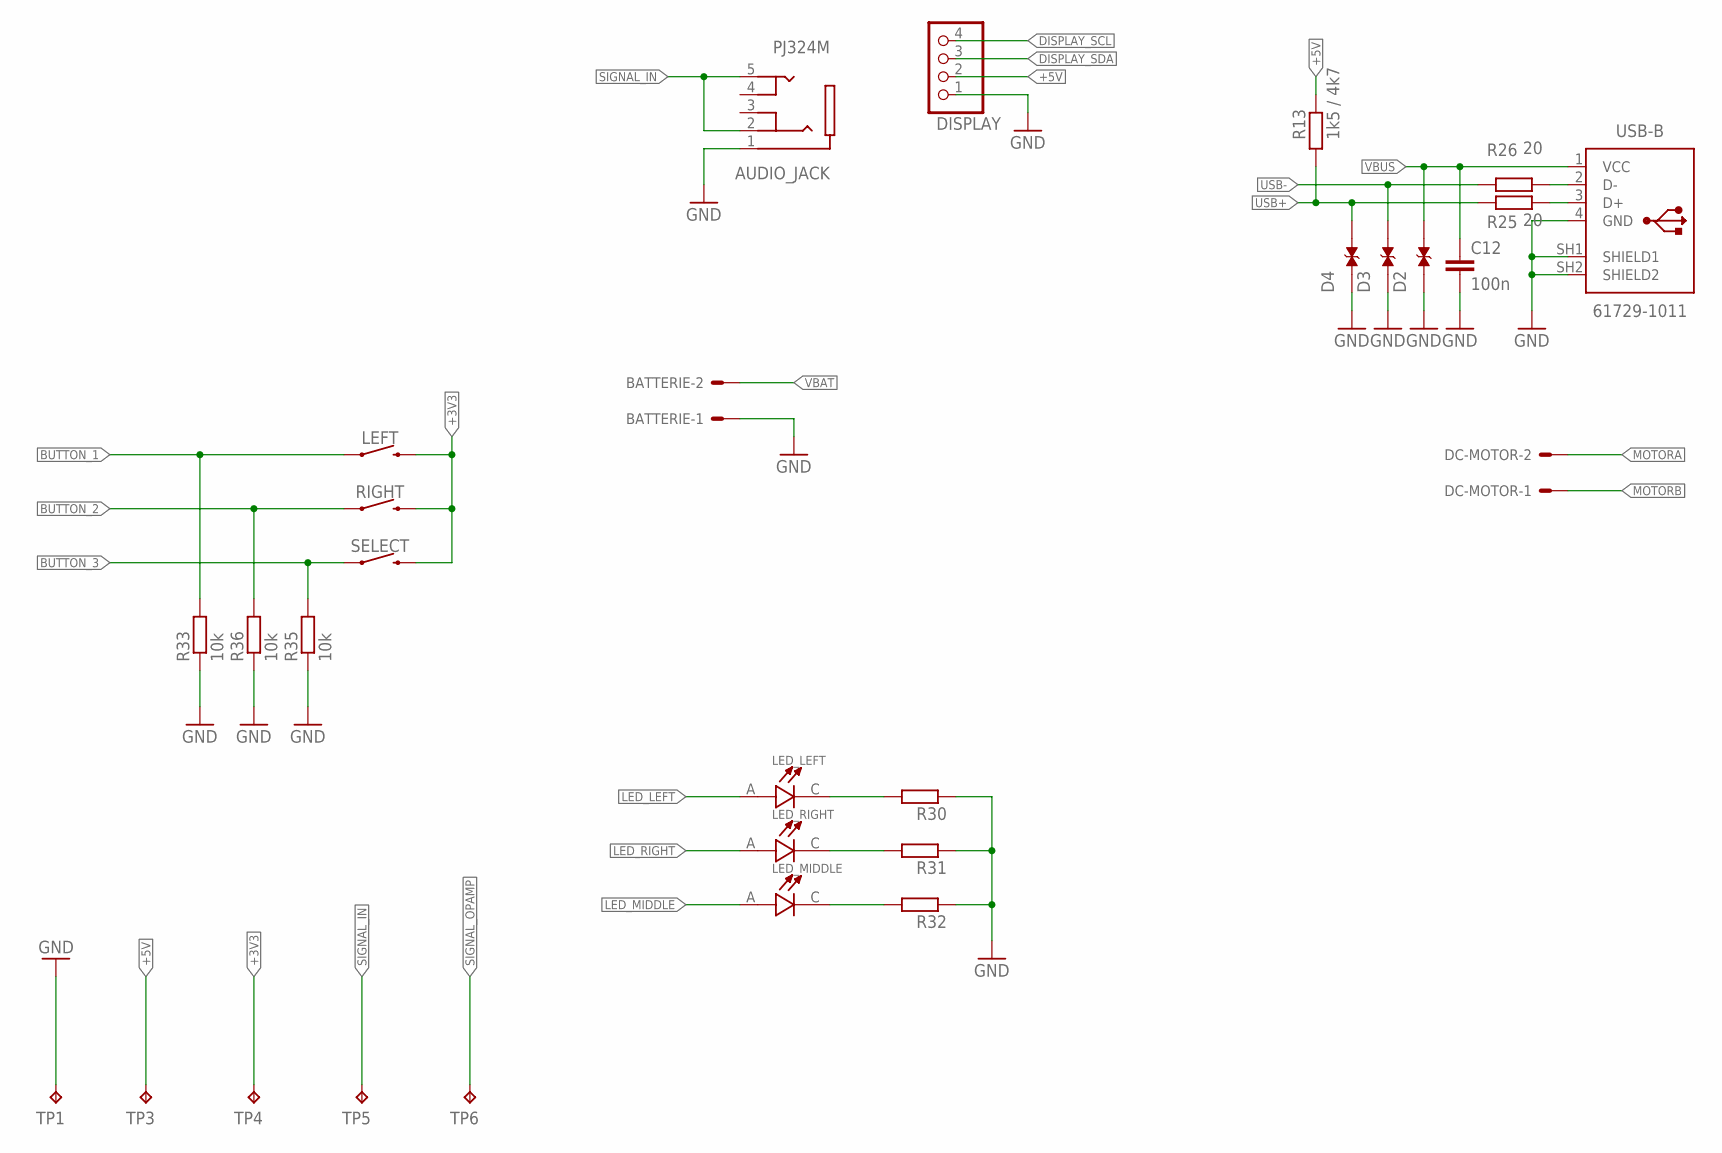
[picture p25: schematic AutoTunerV1.sch, sheet 3, I/O]

Parts:
AUDIO_JACK: PJ324M; WENZHOU_PJ324M
BATTERIE: 22-27-2021-02; 6410-02
C12: 100n; C0805
D2, D3, D4: TESD5V0L1UC_RJG; DIO_TESD5V0L1UC_RJG; LCSC_PART C7420372
DC-MOTOR: 22-27-2021-02; 6410-02
DISPLAY: PINHD-1X4; 1X04
LED_LEFT: L-53GD; LEDRD254W50D500H1060
LED_MIDDLE: L-53GD; LEDRD254W50D500H1060
LED_RIGHT: L-53GD; LEDRD254W50D500H1060
LEFT: MOMENTARY-SWITCH-SPST-PTH-12MM; TACTILE_SWITCH_PTH_12MM
R13: 1k5 / 4k7; R0805
R25, R26: 20; R0805
R30, R31, R32: R-EU_R0805; R0805
R33, R35, R36: 10k; R0805
RIGHT: MOMENTARY-SWITCH-SPST-PTH-12MM; TACTILE_SWITCH_PTH_12MM
SELECT: MOMENTARY-SWITCH-SPST-PTH-12MM; TACTILE_SWITCH_PTH_12MM
TP1, TP3, TP4, TP5, TP6: TPB1,27; B1,27
USB-B: 61729-1011; 61729-1011BLF

Connections:
+3V3: LEFT.3 (2), RIGHT.3 (2), SELECT.3 (2), TP4.TP; also elsewhere on the board
+5V: DISPLAY.2, R13.2, TP3.TP; also elsewhere on the board
BUTTON_1: LEFT.1, R33.2; also elsewhere on the board
BUTTON_2: R36.2, RIGHT.1; also elsewhere on the board
BUTTON_3: R35.2, SELECT.1; also elsewhere on the board
DISPLAY_SCL: DISPLAY.4; also elsewhere on the board
DISPLAY_SDA: DISPLAY.3; also elsewhere on the board
GND: AUDIO_JACK.1 (SLEEVE), BATTERIE.1, C12.2, D2.1, D3.1, D4.1, DISPLAY.1, R30.1, R31.1, R32.1, R33.1, R35.1, R36.1, TP1.TP, USB-B.4 (GND), USB-B.SH1 (SHIELD1), USB-B.SH2 (SHIELD2); also elsewhere on the board
LED_LEFT: LED_LEFT.A; also elsewhere on the board
LED_MIDDLE: LED_MIDDLE.A; also elsewhere on the board
LED_RIGHT: LED_RIGHT.A; also elsewhere on the board
MOTORA: DC-MOTOR.2; also elsewhere on the board
MOTORB: DC-MOTOR.1; also elsewhere on the board
unnamed: LED_LEFT.C, R30.2
unnamed: LED_RIGHT.C, R31.2
unnamed: LED_MIDDLE.C, R32.2
unnamed: R25.2, USB-B.3 (D+)
unnamed: R26.2, USB-B.2 (D-)
SIGNAL_IN: AUDIO_JACK.2 (RING_1), AUDIO_JACK.5 (TIP_2), TP5.TP; also elsewhere on the board
SIGNAL_OPAMP: TP6.TP; also elsewhere on the board
USB+: D4.2, R13.1, R25.1; also elsewhere on the board
USB-: D3.2, R26.1; also elsewhere on the board
VBAT: BATTERIE.2; also elsewhere on the board
VBUS: C12.1, D2.2, USB-B.1 (VCC); also elsewhere on the board

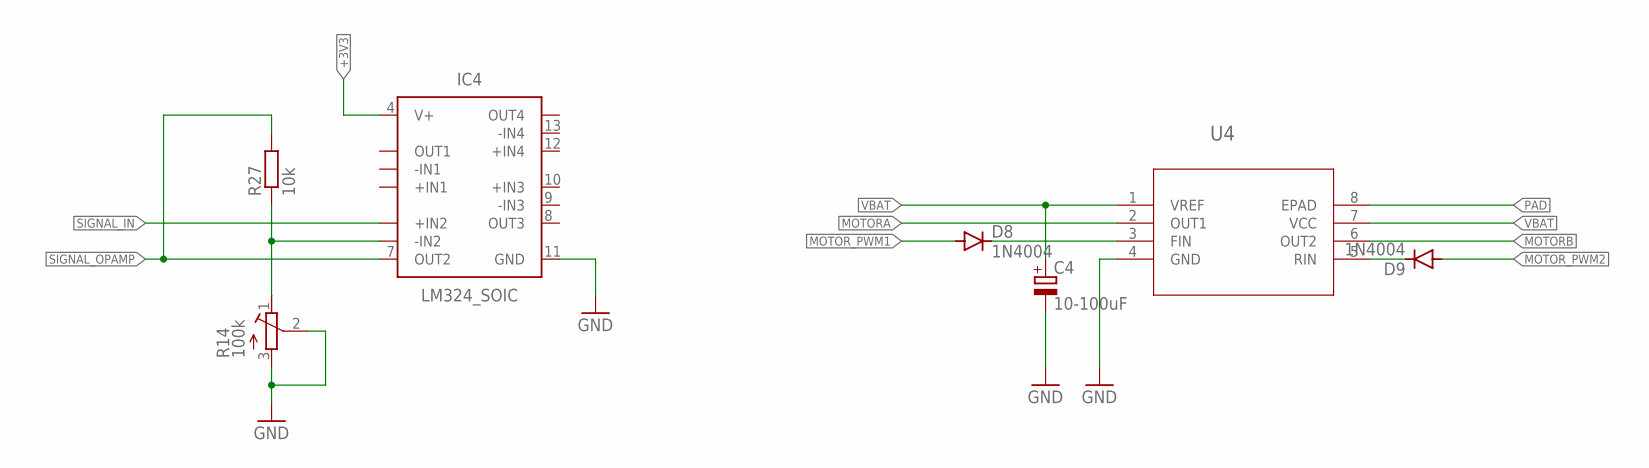
[picture p26: schematic AutoTunerV1.sch, sheet 4, Motor Steuerung / Signal Verarbeitung]

Parts:
C4: 10-100uF; B45181A
D8, D9: 1N4004; DO41-10
IC4: LM324_SOIC; SOIC127P600X175-14N; LCSC_PART C71035
R14: 100k; RTRIM43P
R27: 10k; R0805
U4: BD6222HFP-TRHRP7_ROM-M; HRP7_ROM-M

Connections:
+3V3: IC4.4 (V+); also elsewhere on the board
GND: C4.-, IC4.11 (GND), R14.2 (S), R14.3 (A), U4.4 (GND); also elsewhere on the board
MOTORA: U4.2 (OUT1); also elsewhere on the board
MOTORB: U4.6 (OUT2); also elsewhere on the board
MOTOR_PWM1: D8.A; also elsewhere on the board
MOTOR_PWM2: D9.A; also elsewhere on the board
unnamed: D8.C, U4.3 (FIN)
unnamed: D9.C, U4.5 (RIN)
unnamed: IC4.6 (-IN2), R14.1 (E), R27.1
PAD: U4.8 (EPAD)
SIGNAL_IN: IC4.5 (+IN2); also elsewhere on the board
SIGNAL_OPAMP: IC4.7 (OUT2), R27.2; also elsewhere on the board
VBAT: C4.+, U4.1 (VREF); also elsewhere on the board

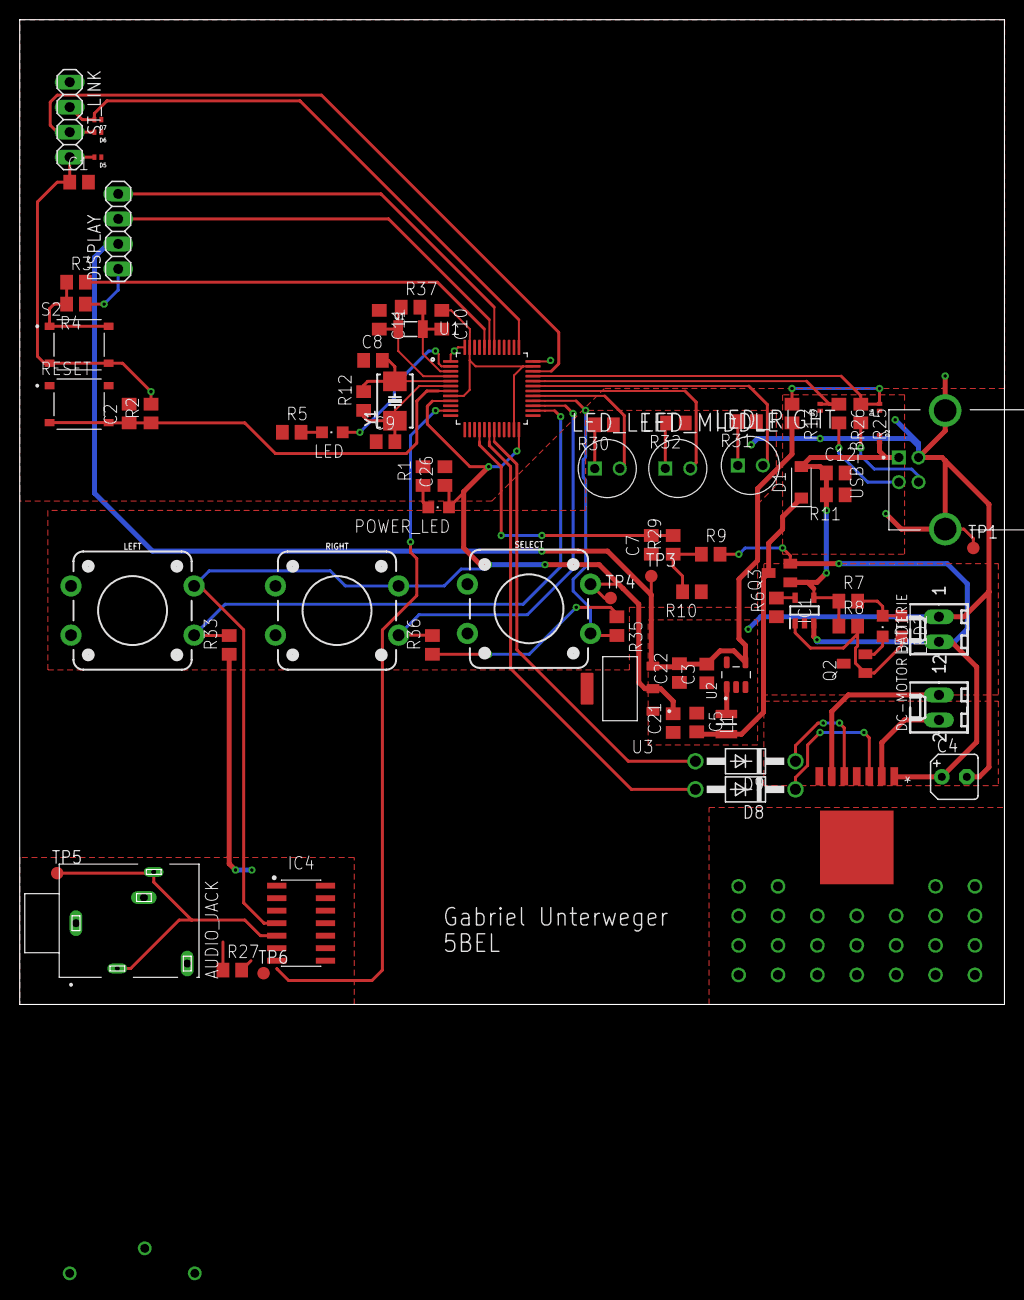
[picture p27: board AutoTunerV1.brd from above]

Board: 2 copper layers, 100.0 x 100.0 mm, 82 parts (1 on the bottom side), 49 nets.
