Theminestone/AutoTuner/code/stm32/include/MainStates.h

#ifndef STM32_MAINSTATES_H
#define STM32_MAINSTATES_H

#include "Globals.h"
#include "STATE.h"
#include "SettingsState.h"

void idle();

void tune_e2();

void tune_a2();

void tune_d3();

void tune_g3();

void tune_h3();

void tune_e4();

void toHigh();

void toLow();

void inTune();

void inIdle();

void writeLCD();

void debug();

#endif //STM32_MAINSTATES_H
