Theminestone/AutoTuner/code/stm32/src/Globals.cpp

#include "Globals.h"

LiquidCrystal_I2C lcd(0x27, 16, 2);

Buzzer buzzer(BUZZER_PIN, BUZZER_STATE);

Button button_left(BUTTON_LEFT, DEBOUNCETIME);
Button button_right(BUTTON_RIGHT, DEBOUNCETIME);
Button button_middle(BUTTON_MIDDLE, DEBOUNCETIME);

LED led_indicator(LED_INDICATOR);
LED led_left(LED_LEFT);
LED led_right(LED_RIGHT);
LED led_middle(LED_MIDDLE);

LED custom1(CUSTOM1);
LED custom2(CUSTOM2);
LED custom3(CUSTOM3);
LED custom4(CUSTOM4);

Motor motor(MOTOR_FIN, MOTOR_RIN);

Signal signal_in(SIGNAL_IN, MAX_CYCLES, SAMPLE_RATE);

String lcd_text_oben = "                ";
String lcd_text_unten = "                ";

MAIN_STATE mainState = STATE_IDLE;
SIGNAL_STATE signalState = SIGNAL_WAIT;
SETTINGS_STATE settingsState = SETTINGS_MAIN;
