Theminestone/AutoTuner/(commit log)

2023-10-26 begin schematic
2023-11-15 code init
    [AutoTuner.sch]
2023-11-19 beta schemaic
    [AutoTuner.sch]
2023-11-22 schematic version 1
2023-11-23 schematic beta 1
    [AutoTuner.brd, AutoTuner.sch]
2023-11-28 board v1 release
    [AutoTuner.brd, AutoTunerV1.brd, AutoTunerV1.sch]
2023-12-11 board v2 release
    [AutoTunerV1.brd, AutoTunerV2.brd, AutoTunerV2.sch]
2023-12-22 board v2 release 2.0
    [AutoTunerV2.brd, AutoTunerV2.sch]
2023-12-28 board v2 main release & oder
    [AutoTunerV2.brd, AutoTunerV2.sch, AutoTunerV2_bom.csv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]
2024-03-03 basic structure
    [AutoTunerV1.brd, AutoTunerV1.sch, AutoTunerV2.brd, AutoTunerV2.sch, AutoTunerV3.brd, AutoTunerV3.sch, signal in 2.0.ods, signal in.ods]
2024-03-24 frequency calcs
    [AutoTunerV3.brd, AutoTunerV3.sch]
2024-04-04 successful freq read && button fix
    [AutoTunerV3.brd, AutoTunerV3.sch, Deckel.stl, Gehaeuse.stl, Motor_Aufsatz.stl, frequency calc.xlsx, signal in 2.0.ods, signal in.ods]
2024-04-04 board v3 improvements
    [AutoTunerV3.brd, AutoTunerV3.sch]
2024-04-08 board v3 dcdc design change
    [AutoTunerV3.brd, AutoTunerV3.sch, AutoTunerV3_bom.csv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]
2024-04-08 board v3 finished
    [AutoTunerV3.brd, AutoTunerV3.sch, AutoTunerV3_bom.csv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]
2024-04-10 settings menu
    [AutoTunerV3.brd, AutoTunerV3.sch]
2024-04-15 battery %
2024-04-24 critical bat fault & buzzer
    [AutoTunerV3.brd, AutoTunerV3.sch]
2024-05-06 code cleanup
    [Deckel.stl]
