Theminestone/AutoTuner/pcb/v3/board.png

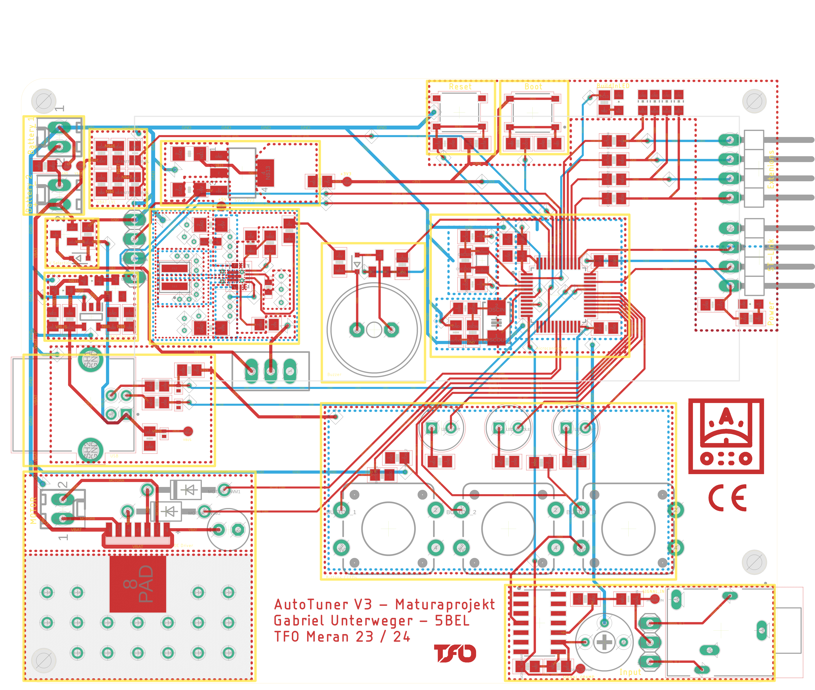
pcb/v3/board.png
